COMANDLab/SEA_Exoskeleton/Photos/Design Section.png

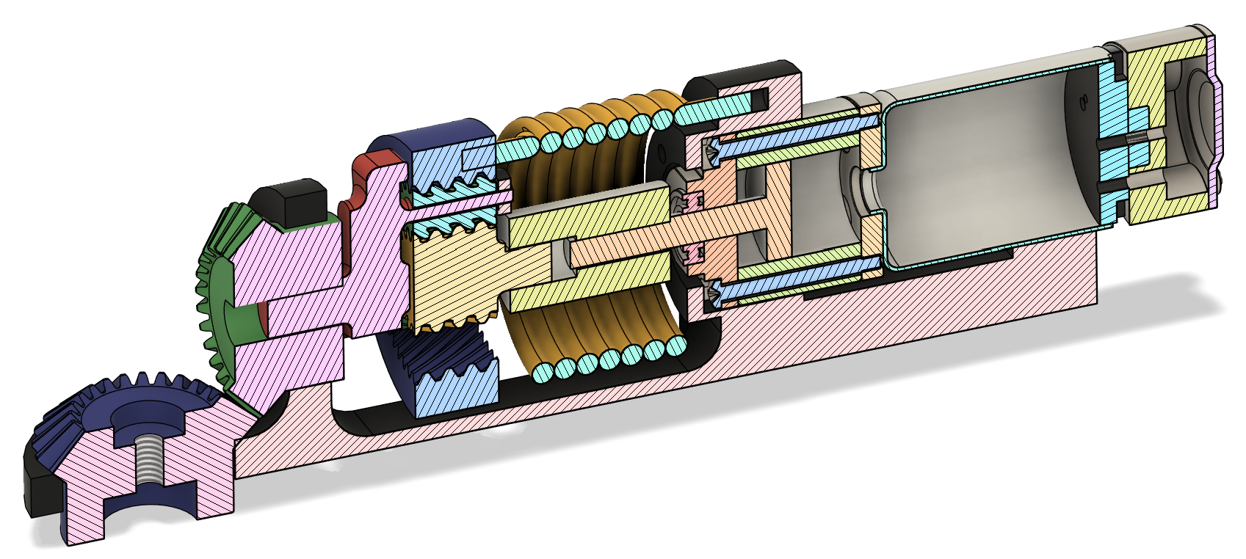
Photos/Design Section.png
