COMANDLab/SEA_Exoskeleton/Photos/Original Design.png

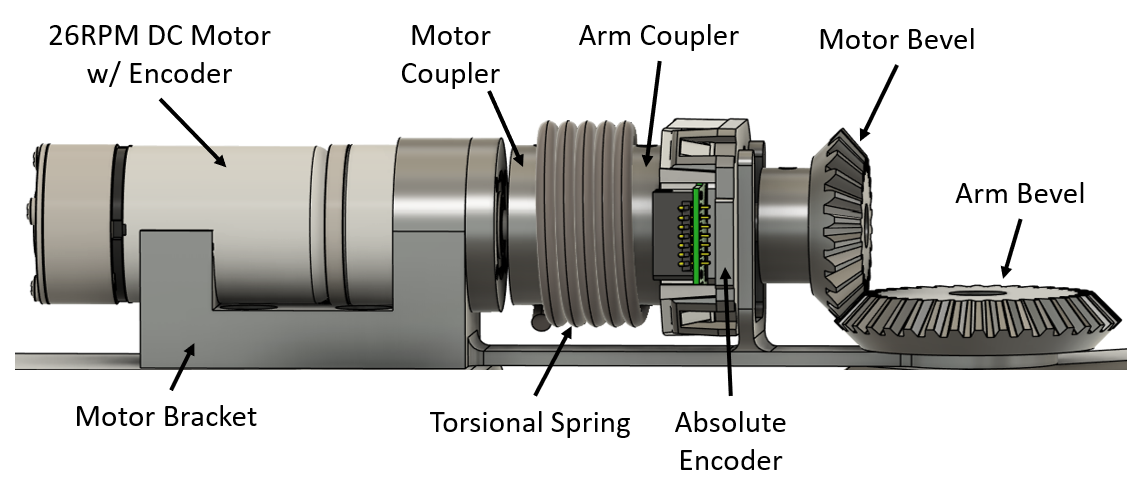
Photos/Original Design.png
