COMANDLab/SEA_Exoskeleton/README.md

# SEA_Exoskeleton
3D Printed Series Elastic Actuator for Elbow Exoskeleton
