COMANDLab/SEA_Exoskeleton/Posters/Hailey Levan Poster.pdf

# Characterizing Joint Compliance and Dynamics in SEA Arm Exoskeleton for Post-Stroke Rehabilitation

Hailey Levan, Ben Jenks, M.S., Dr. Filip Stefanovic, Ph.D.
Department of Biomedical Engineering, State University of New York at Buffalo

## Introduction

Approximately 15 million people experience a stroke

annually, with 62%-88% of survivors suffering from post-

stroke upper limb impairment [1,2]. Rehabilitation

involves intensive repetition of elbow movements, often

limited by patient fatigue or spasticity [3]. Exoskeletons

can assist in such exercises but are often uncomfortable

and may cause injury due to their rigid interactions with

the patient's arm [4]. To address this, a 3D printed

exoskeleton with a Series Elastic Actuator (SEA)

compliant elbow joint was designed. It uses an elastic

elbow joint comprised of a helical planetary gear and a

torsional spring, providing a more comfortable and cost-

effective assistive device for post-stroke rehabilitation [4].

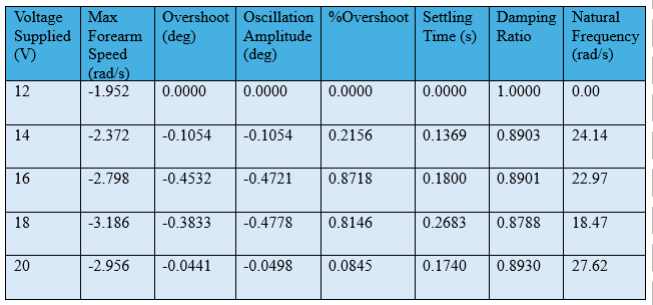
[picture p3: figure]

## Experimental Methods

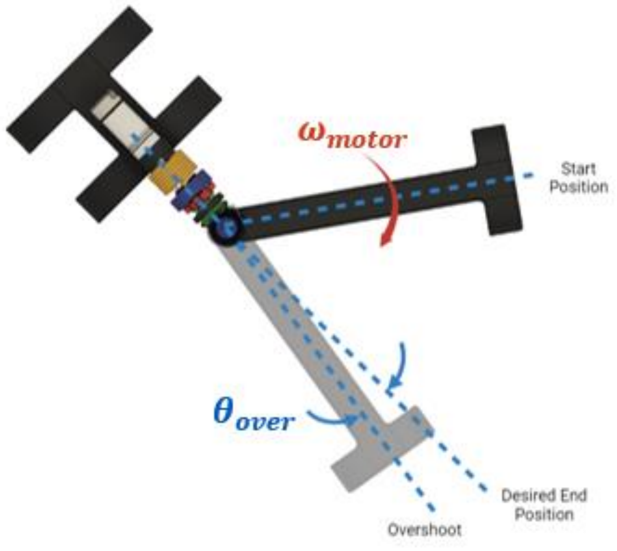
[picture p4: figure]
Figure A: neque dignissim, and in aliquet nisl et umis.

## Results

## Conclusion

## References

1. WHO EMRO | Stroke, Cerebrovascular accident | Health topics.
(n.d.). World Health Organization - Regional Office for the Eastern Mediterranean. https://www.emro.who.int/health-topics/strokecerebrovascular-accident/index.html
2. Stinear, C. M., Lang, C. E., Zeiler, S., & Byblow, W. D. (2020). Advances and challenges in stroke rehabilitation. Lancet Neurology, 19(4), 348–360. https://doi.org/10.1016/s1474-4422(19)30415-6
3. Kawahira, K., Shimodozono, M., Etoh, S., Kamada, K., Noma, T., & Tanaka, N. (2010). Effects of intensive repetition of a new facilitation technique on motor functional recovery of the hemiplegic upper limb and hand. Brain Injury, 24(10), 1202–1213. https://doi.org/10.3109/02699052.2010.506855
4. Jenks, B., & Stefanovic, F. (2024). Planetary Gear Series Elastic Actuation for a Compliant Exoskeleton Joint. COMAND Lab, Department of Biomedical Engineering.

www.buffalo.edu

This study characterizes the compliance and dynamics of a planetary gear/torsional spring SEA exoskeleton design to improve elbow joint rehabilitation. Under static loads, the joint achieved a total system compliance of 22.22°

,
with the torsional spring contributing 7.42° of compliance for user safety and comfortability.

In a dynamic test in which the joint’s motor was supplied with different voltage levels, the system was found to maintain a relatively constant damping ratio, even at higher speeds. In general, a higher forearm rotation speed resulted in larger overshoot angles, as well as longer settling times before the system reached steady state.

Future work may include incorporating machine learning to recognize user intent and EMG sensors. These steps would further develop the device to improve rehabilitation success, with the hope of it eventually being utilized as an every day assistive device.

## Acknowledgments

## climb up for summer research

Special thanks to the following organizations for their parts in funding this research:
❖ The Research Foundation for the State University of New York ❖ National Science Foundation Disabilities and Rehabilitation Engineering (Award#: 2130651)
❖ CLIMB Undergraduate Program

Fig 1 (Jenks, B. & Stefanovic, F.):
Top
Component view of torsional spring and planetary gear SEA joint. Bottom
Full model of the SEA device interaction with exoskeleton brackets.

Test 1: Static compliance test

❖ Method: Apply force until spring starts to deform,

then record joint angle using IMUs.

Fig 2 (Created with BioRender): Schematic for static testing procedure.

Fig 3 (Created with BioRender): Schematic for dynamic testing procedure.

To determine the compliancy of the SEA elbow joint,

two tests were run to characterize the device.

Test 2: Dynamic compliance test

❖ Method: Vary speed at which forearm rotates to

desired angle. Collect joint angle data to observe

overshoot and oscillations caused by SEA joint.

❖ Hypothesis: Increased forearm rotation speed = larger

overshoot and subsequent oscillations before

stabilizing.

Test 1: Static compliance test

❖ Across 4 trials each, the average system compliance

(Csys) and the average gear compliance (Cgear ) were

measured.

Csys = 22.22°

Cgear = 14.80°

❖ Spring compliance (Cspring) can be calculated

through:

Cspring = Csys − Cgear = 7.42°

Test 2: Dynamic compliance test

❖ Raw angular velocity data for the forearm was

integrated in MATLAB to acquire angular position data.

Fig 4 (H. Levan):
Example of MATLAB graph created for 5 trials ranging from 12-18V. Zoomed in to better view the moment of overshoot and subsequent transition to steady state.

❖ Within MATLAB, percent overshoot (%os) and settling

time (Ts
) were calculated. With these parameters, the

following equations were used to calculate the damping

ratio (ζ) and natural frequency (ωn) of the system. Table

1 contains all important parameters to characterize the

dynamics of the joint when its motor is supplied with

different voltage levels.

ζ =

ln(

100
%os

)

π

2 + (ln

100
%os

)

2

ωn =

4
Tsζ

Table 1: Necessary parameters to characterize joint dynamics. .
