COMANDLab/SEA_Exoskeleton/Photos/3 Nm arm gears displacement.png

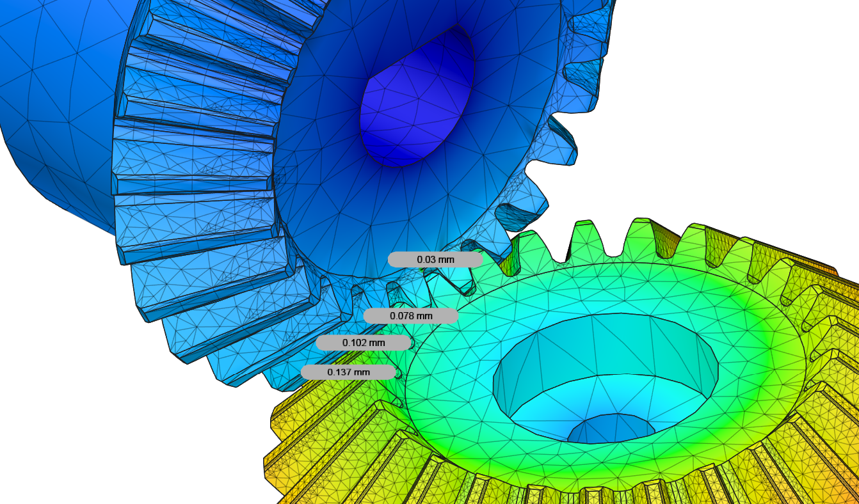
Photos/3 Nm arm gears displacement.png
