COMANDLab/SEA_Exoskeleton/Photos/3 Nm arm gears stress x-axis.png

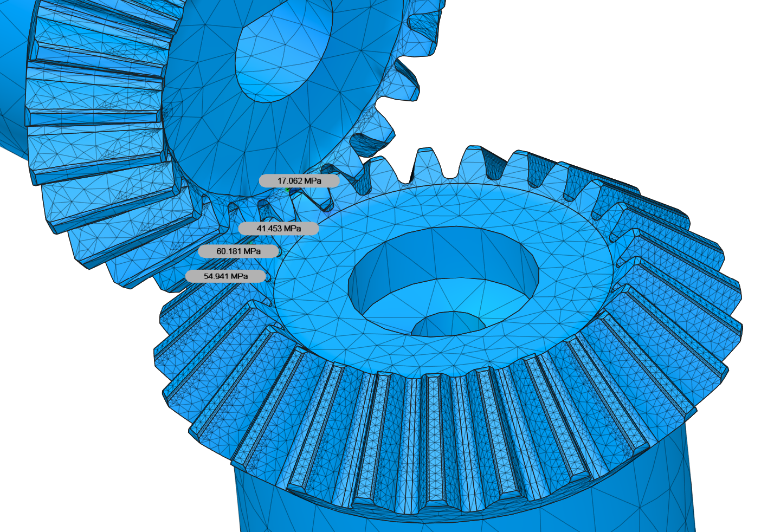
Photos/3 Nm arm gears stress x-axis.png
