COMANDLab/SEA_Exoskeleton/Photos/3 Nm arm gears stress y-axis.png

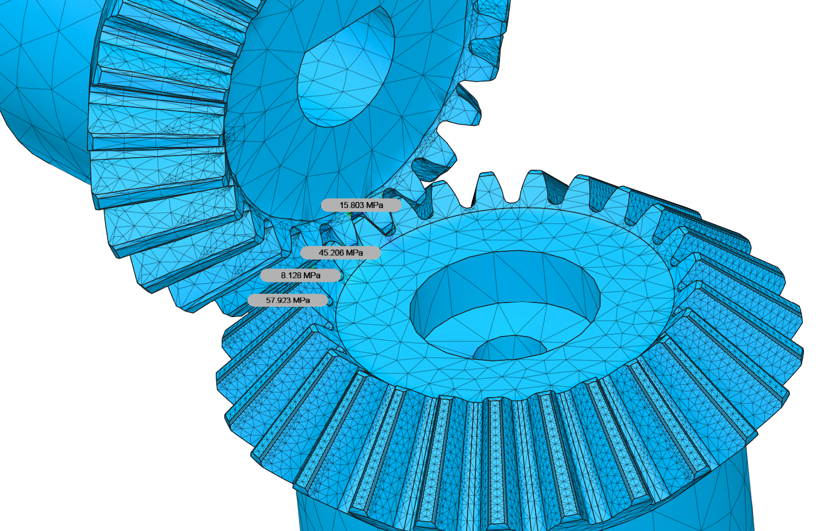
Photos/3 Nm arm gears stress y-axis.png
