COMANDLab/SEA_Exoskeleton/Photos/3 Nm arm gears stress z-axis.png

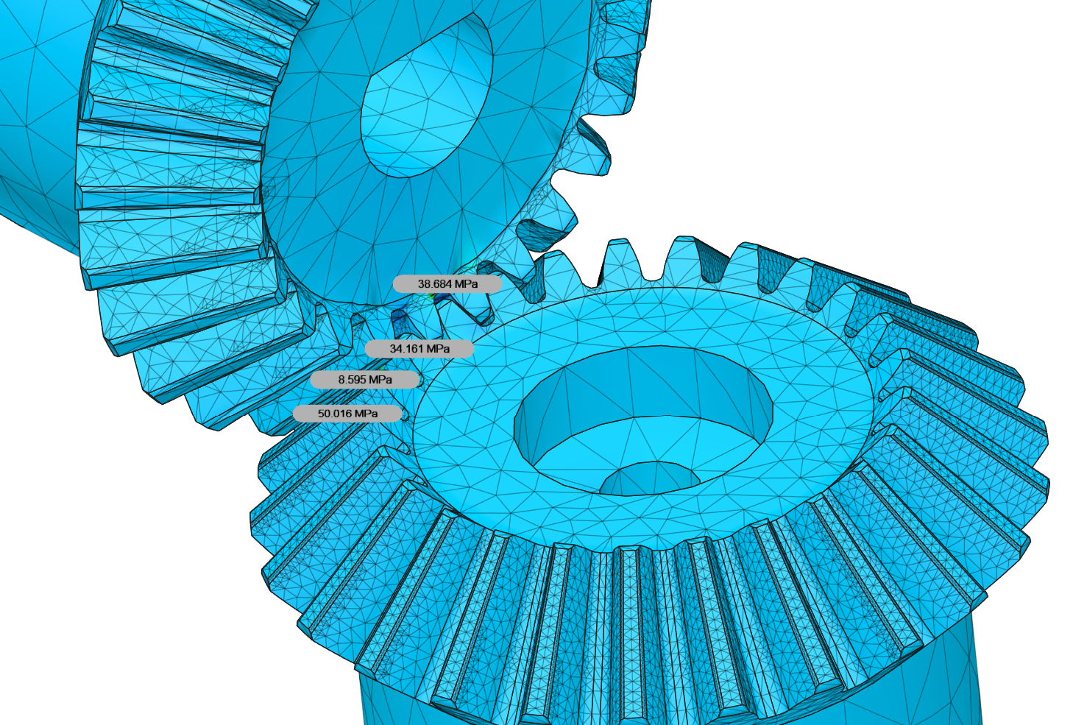
Photos/3 Nm arm gears stress z-axis.png
