COMANDLab/SEA_Exoskeleton/Photos/3 Nm displacement arm side.png

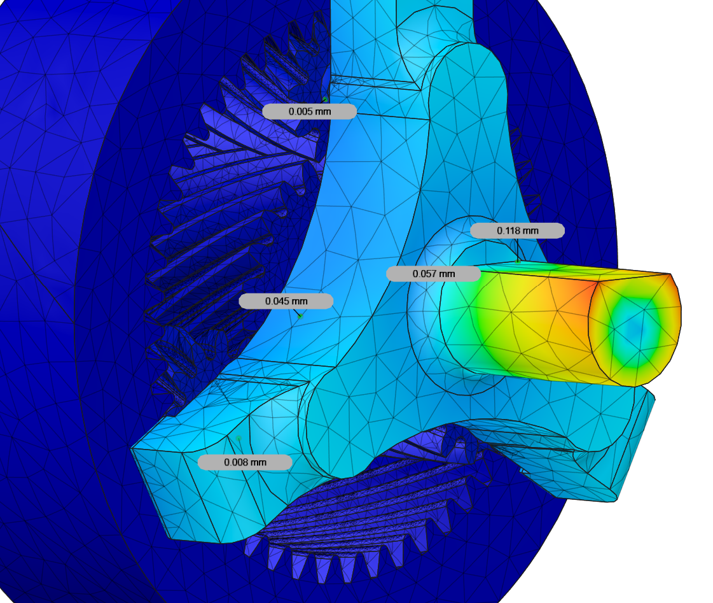
Photos/3 Nm displacement arm side.png
