COMANDLab/SEA_Exoskeleton/Photos/3 Nm displacement sun side.png

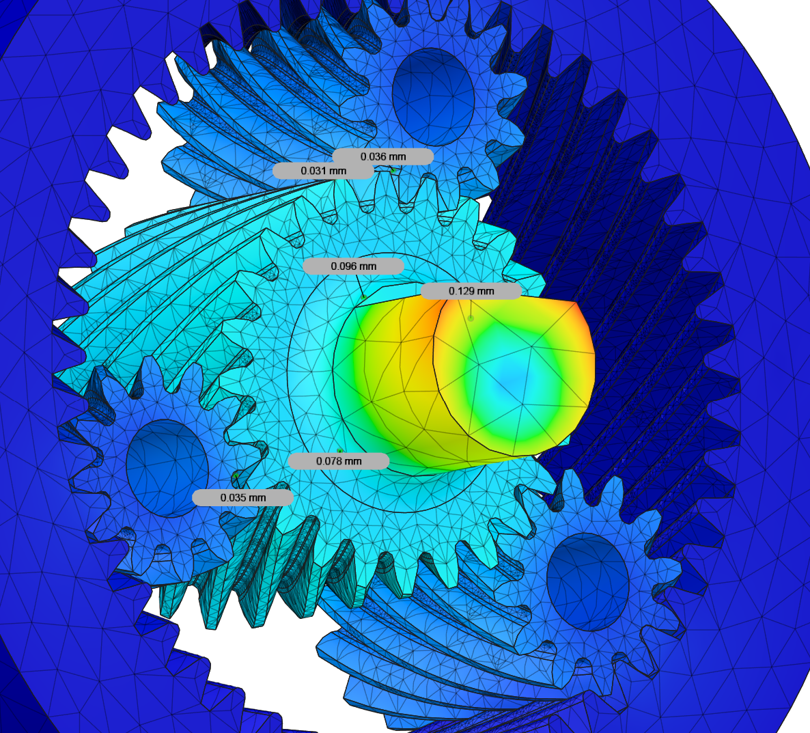
Photos/3 Nm displacement sun side.png
