COMANDLab/SEA_Exoskeleton/Photos/3 Nm stress arm side x-axis.png

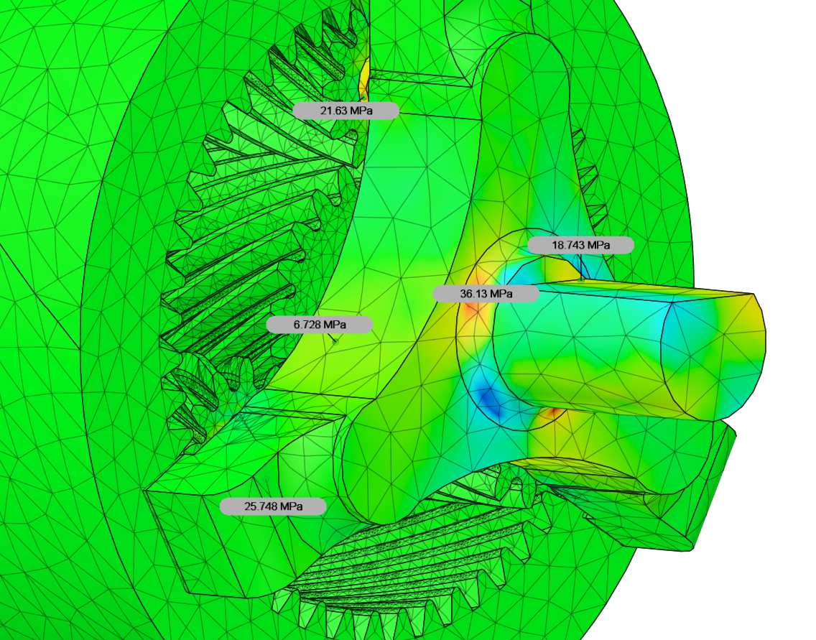
Photos/3 Nm stress arm side x-axis.png
