COMANDLab/SEA_Exoskeleton/Photos/3 Nm stress arm side y-axis.png

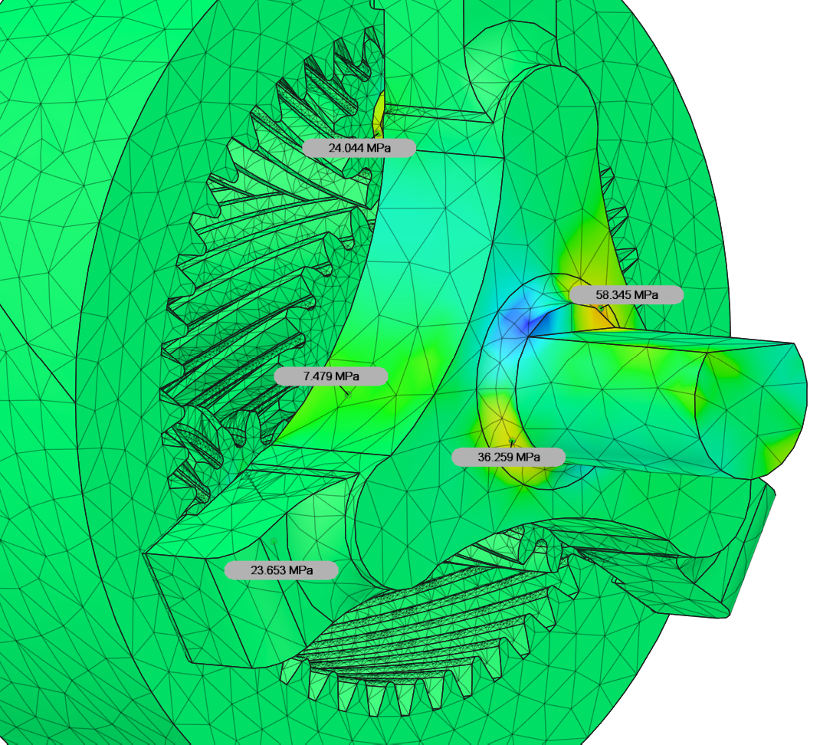
Photos/3 Nm stress arm side y-axis.png
