COMANDLab/SEA_Exoskeleton/Photos/3 Nm stress sun side x-axis.png

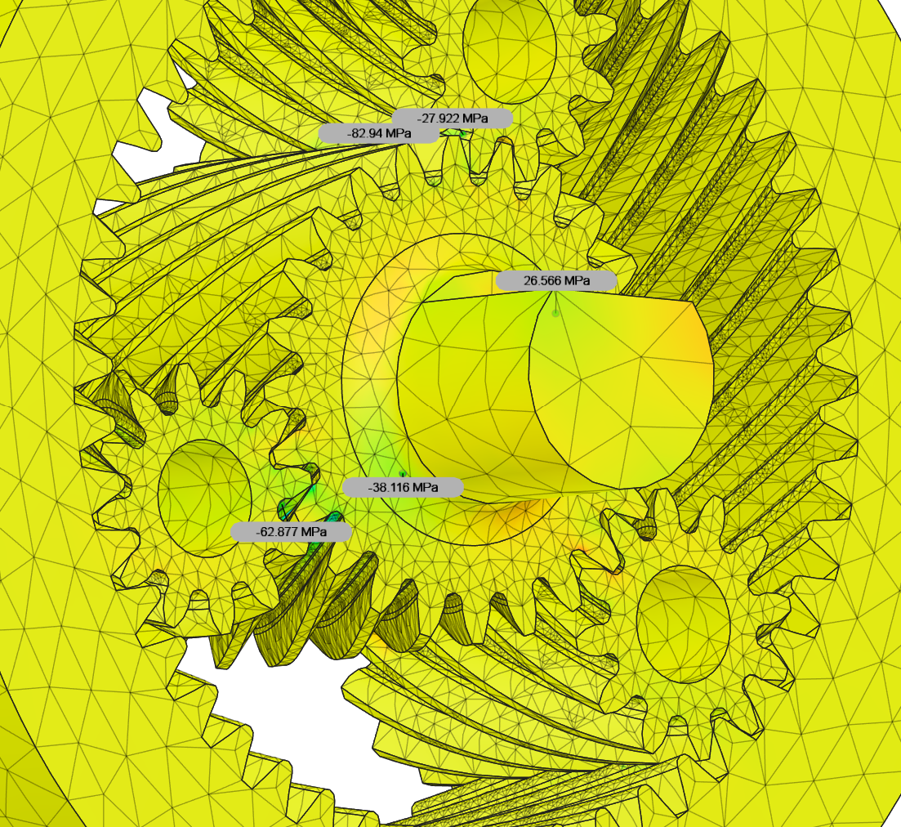
Photos/3 Nm stress sun side x-axis.png
