COMANDLab/SEA_Exoskeleton/Photos/3 Nm stress sun side y-axis.png

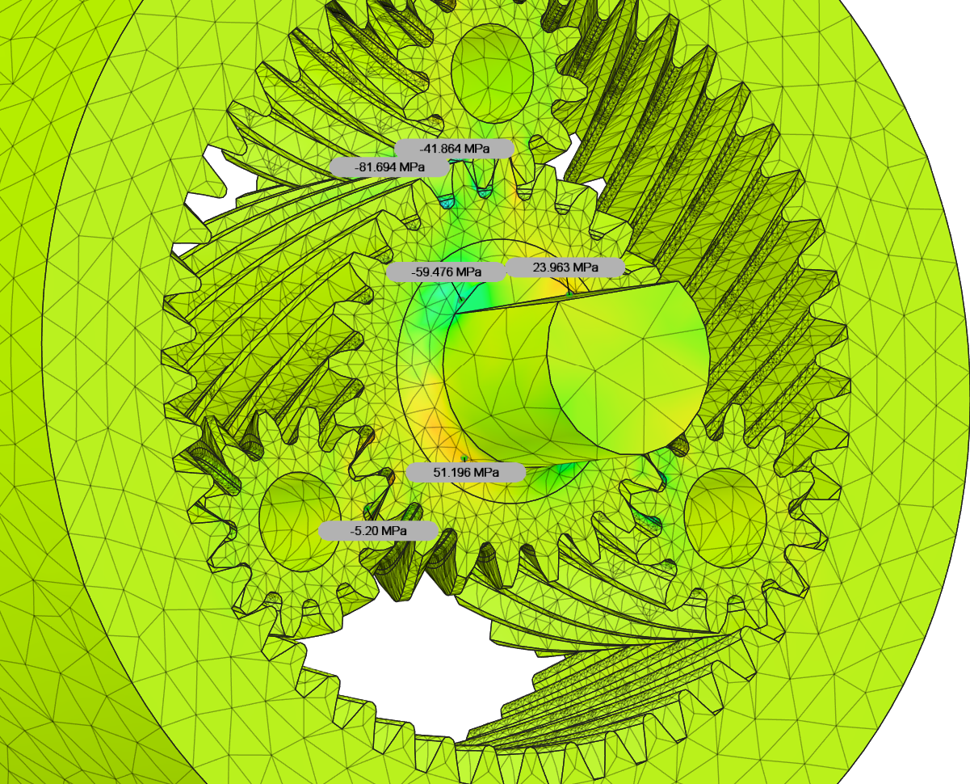
Photos/3 Nm stress sun side y-axis.png
