COMANDLab/SEA_Exoskeleton/Photos/brace.png

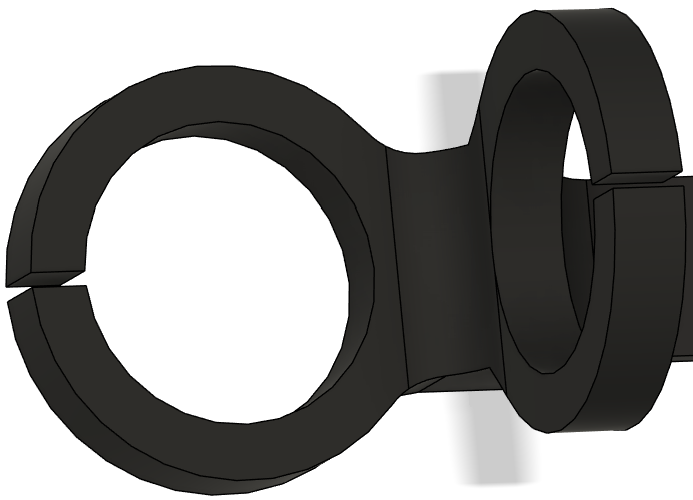
Photos/brace.png
