COMANDLab/SEA_Exoskeleton/Photos/Compliant Actuator.png

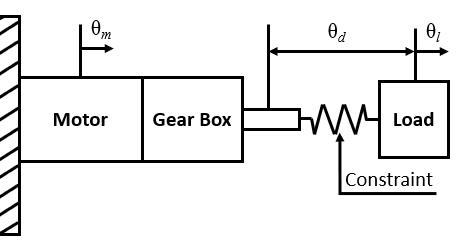
Photos/Compliant Actuator.png
