COMANDLab/SEA_Exoskeleton/Photos/compliant arm.png

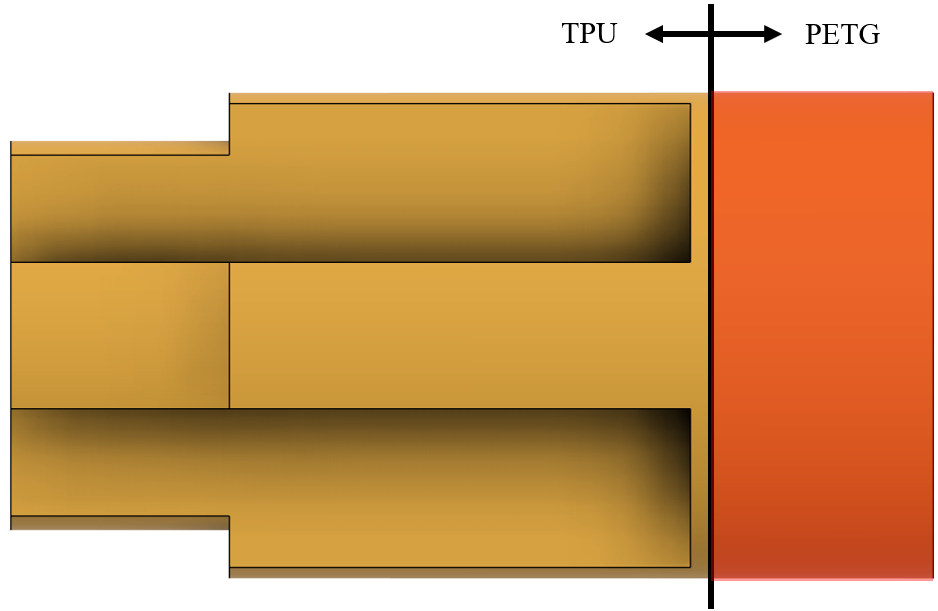
Photos/compliant arm.png
