COMANDLab/SEA_Exoskeleton/Photos/compliant section.png

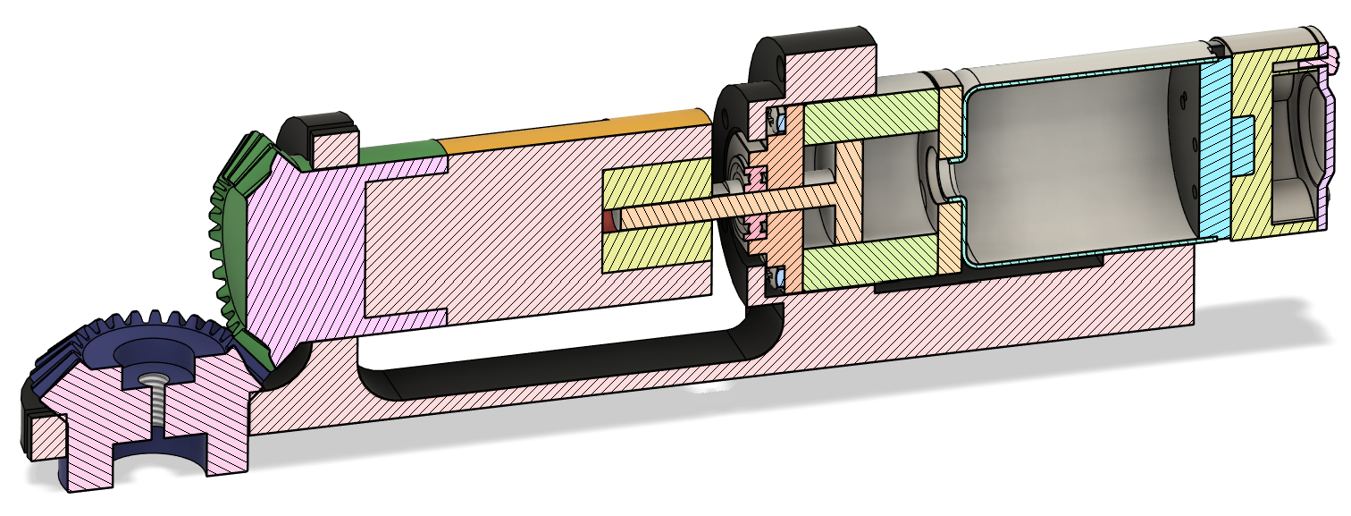
Photos/compliant section.png
