COMANDLab/SEA_Exoskeleton/Photos/Compliant Side View.png

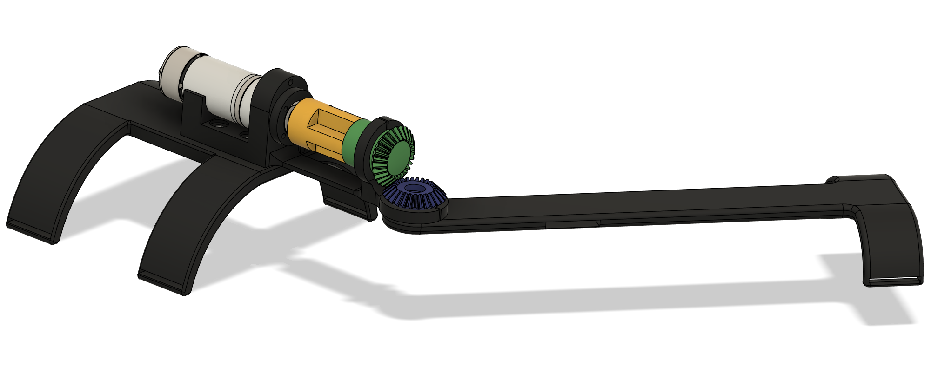
Photos/Compliant Side View.png
