COMANDLab/SEA_Exoskeleton/Photos/cPEA cross.png

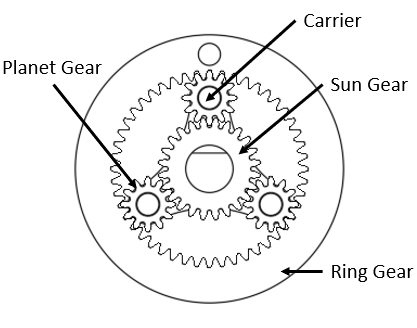
Photos/cPEA cross.png
