COMANDLab/SEA_Exoskeleton/Photos/Dynamic Model.png

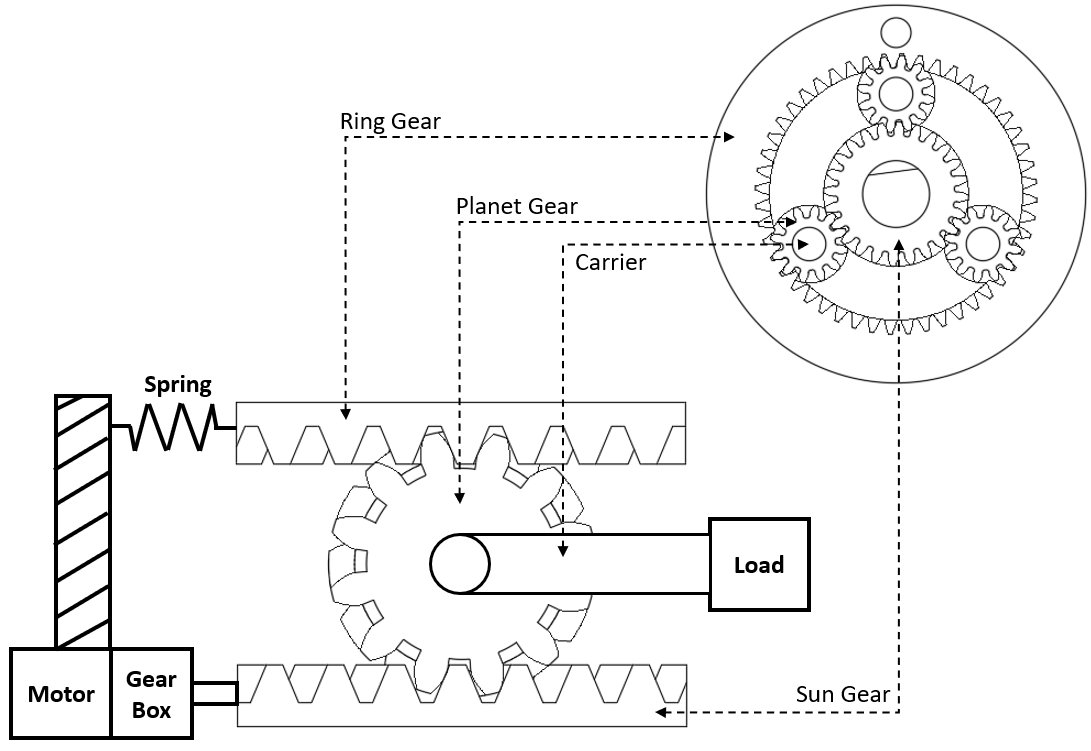
Photos/Dynamic Model.png
