COMANDLab/SEA_Exoskeleton/Photos/Final Design Labeled Componenets.png

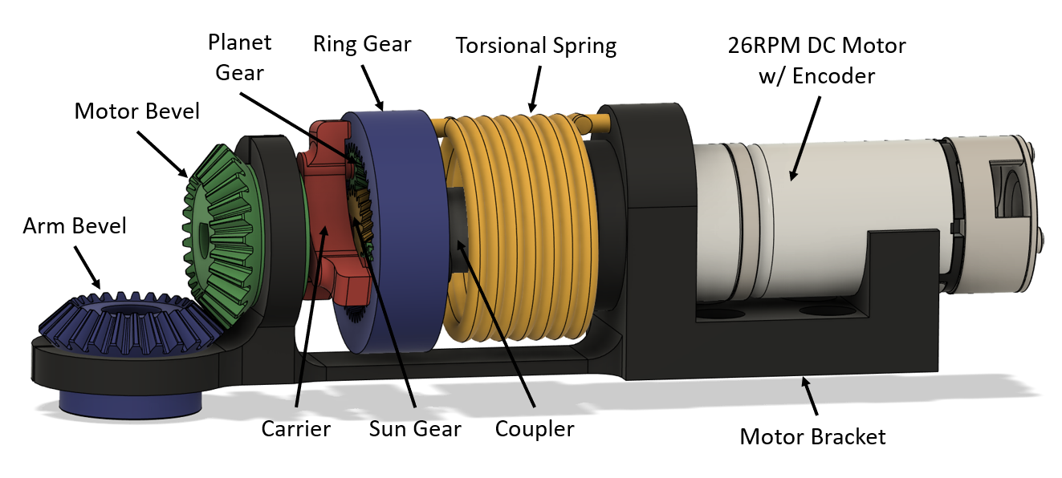
Photos/Final Design Labeled Componenets.png
