COMANDLab/SEA_Exoskeleton/Photos/Final Model Compliant Arm Labeled.png

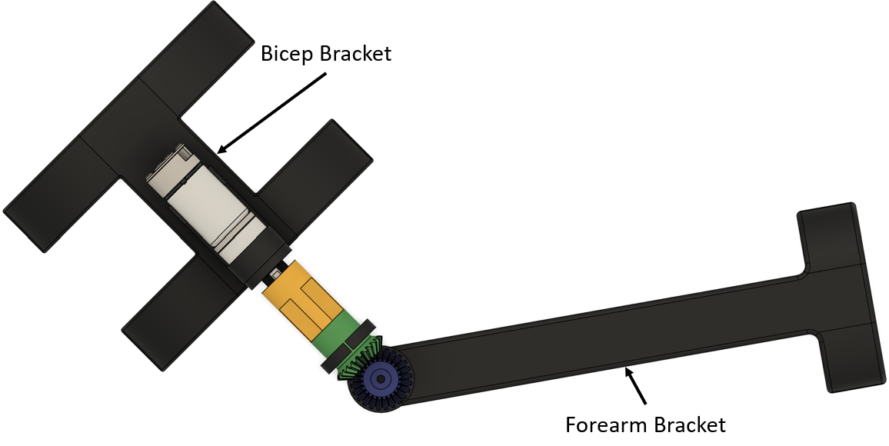
Photos/Final Model Compliant Arm Labeled.png
