COMANDLab/SEA_Exoskeleton/Photos/Final Model Compliant Arm.png

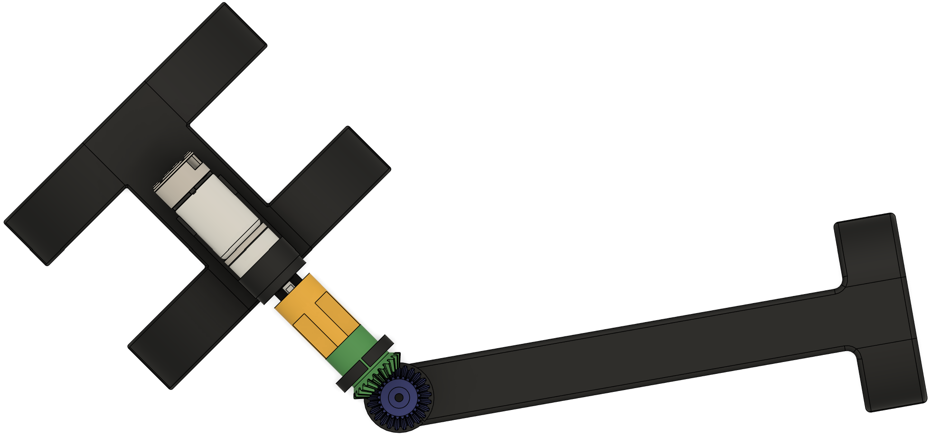
Photos/Final Model Compliant Arm.png
