COMANDLab/SEA_Exoskeleton/Photos/Final Model Compliant Labeled Componenets.png

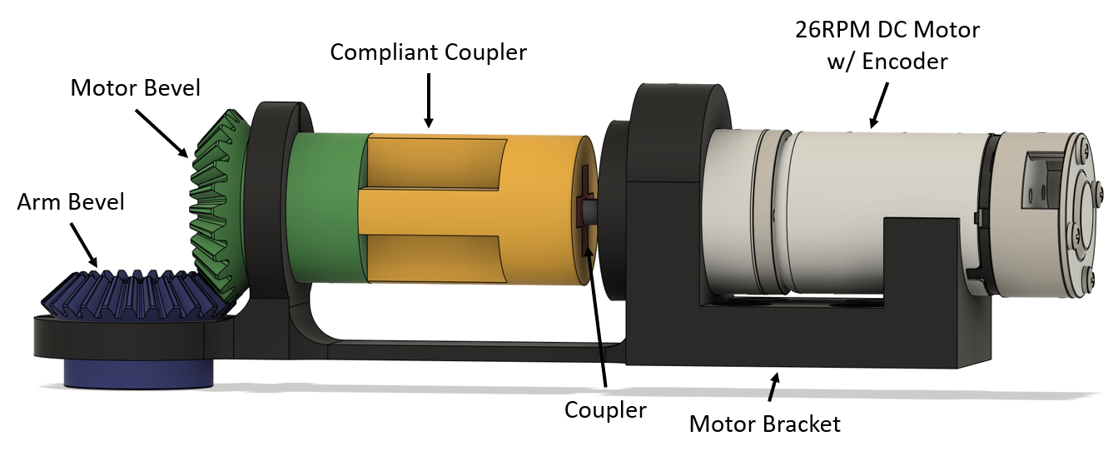
Photos/Final Model Compliant Labeled Componenets.png
