COMANDLab/SEA_Exoskeleton/Photos/Final Model Compliant Section Labeled.png

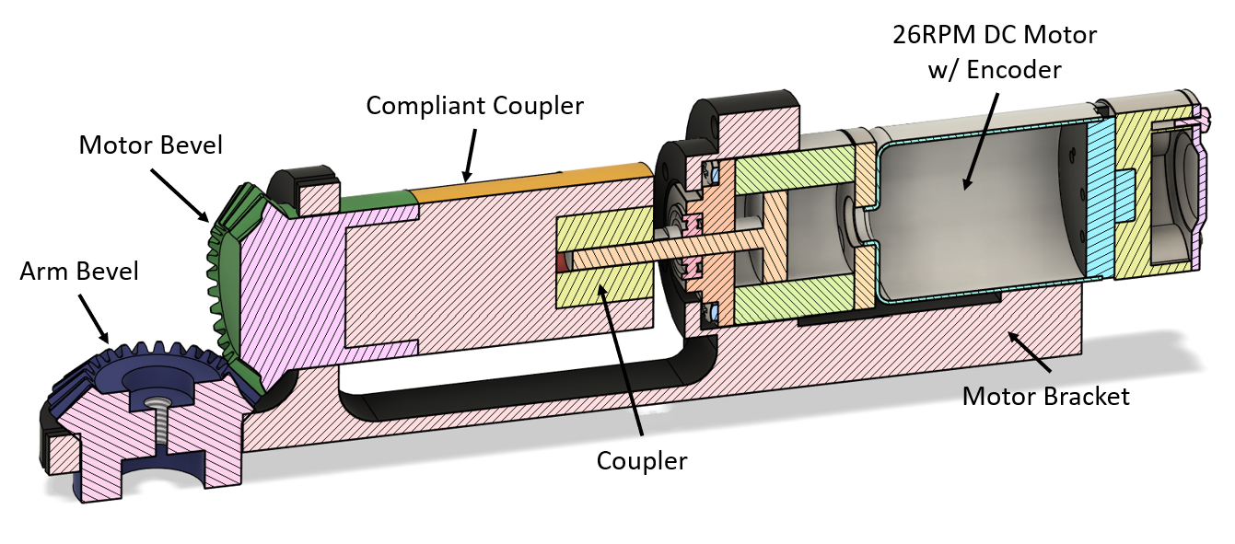
Photos/Final Model Compliant Section Labeled.png
