COMANDLab/SEA_Exoskeleton/Photos/Final Model Spring Labeled.png

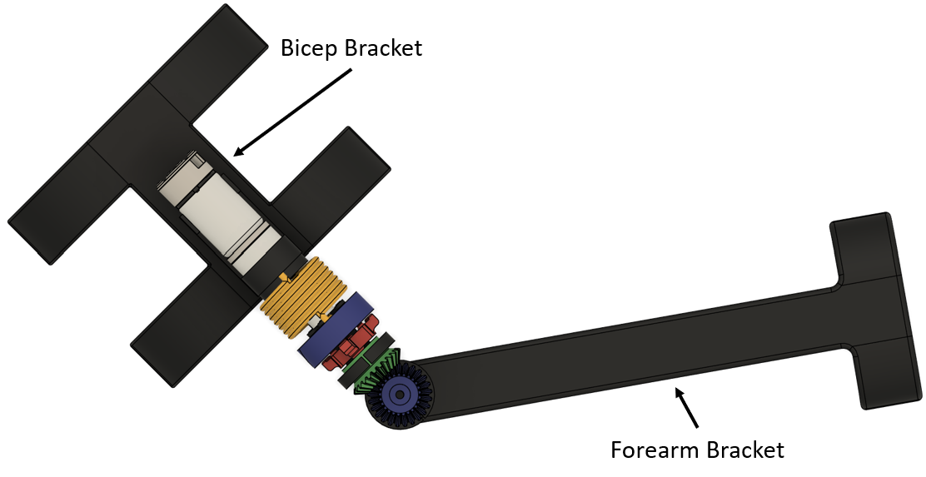
Photos/Final Model Spring Labeled.png
