COMANDLab/SEA_Exoskeleton/Photos/Forearm Cuff.png

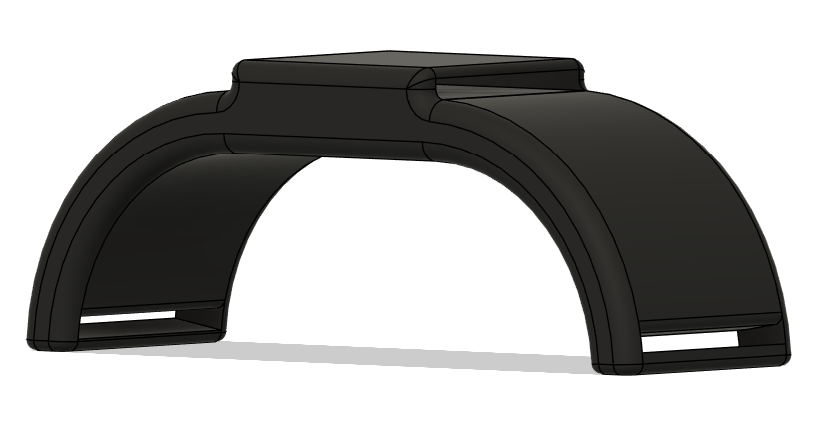
Photos/Forearm Cuff.png
