COMANDLab/SEA_Exoskeleton/Photos/Motor bracket.png

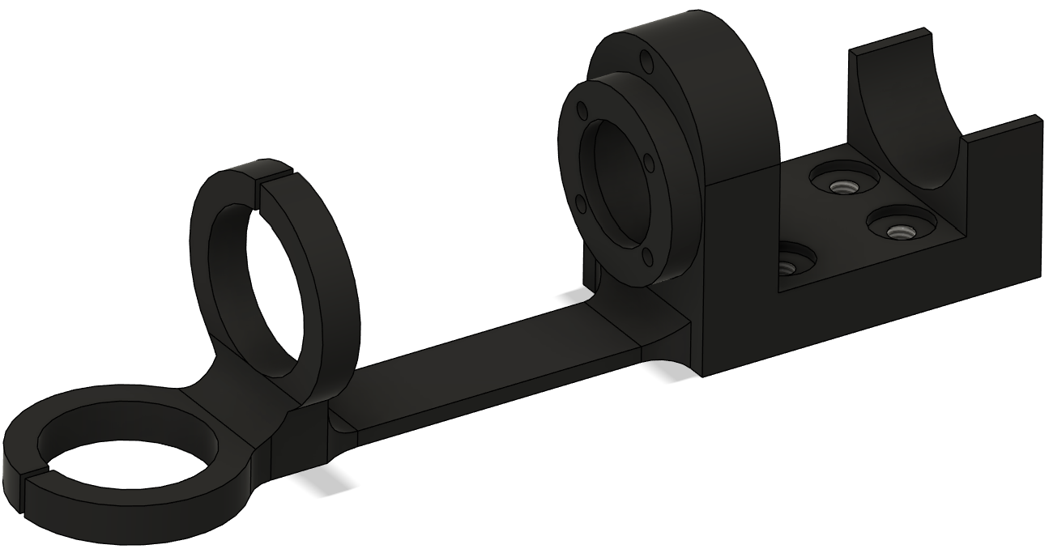
Photos/Motor bracket.png
