COMANDLab/SEA_Exoskeleton/Photos/Motor w Encoder.jpg

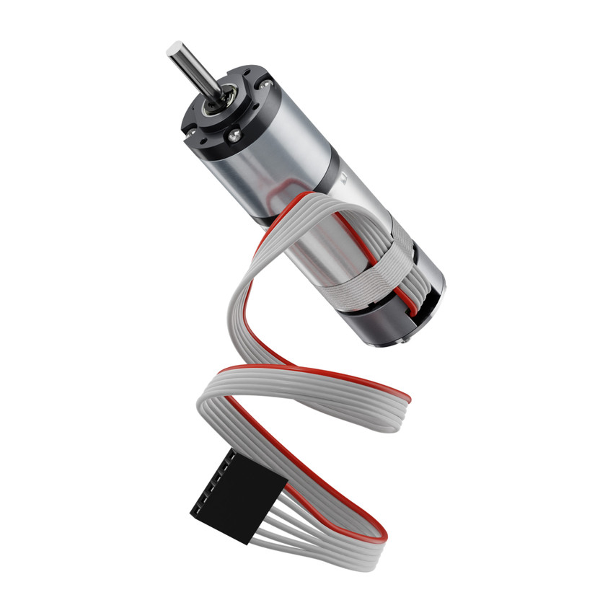
Photos/Motor w Encoder.jpg
