COMANDLab/SEA_Exoskeleton/Photos/origianl cuff.png

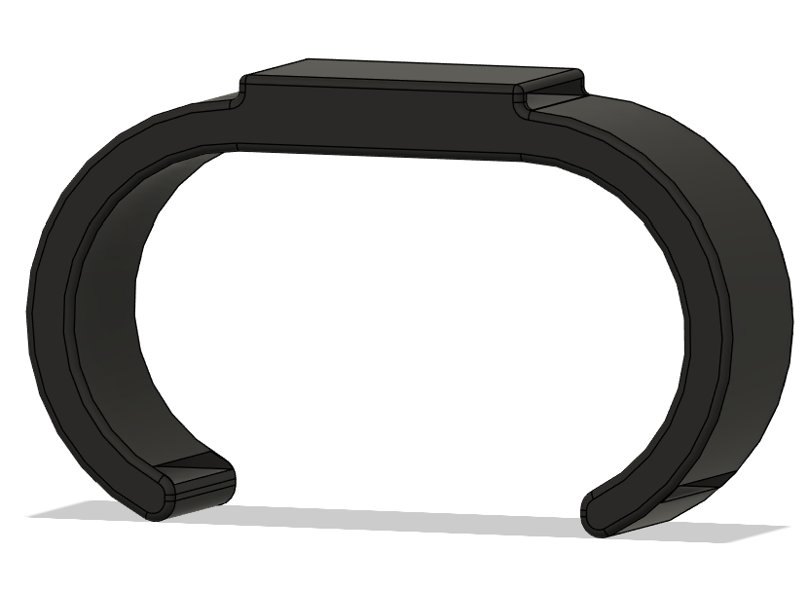
Photos/origianl cuff.png
