COMANDLab/SEA_Exoskeleton/Photos/planetary gear.png

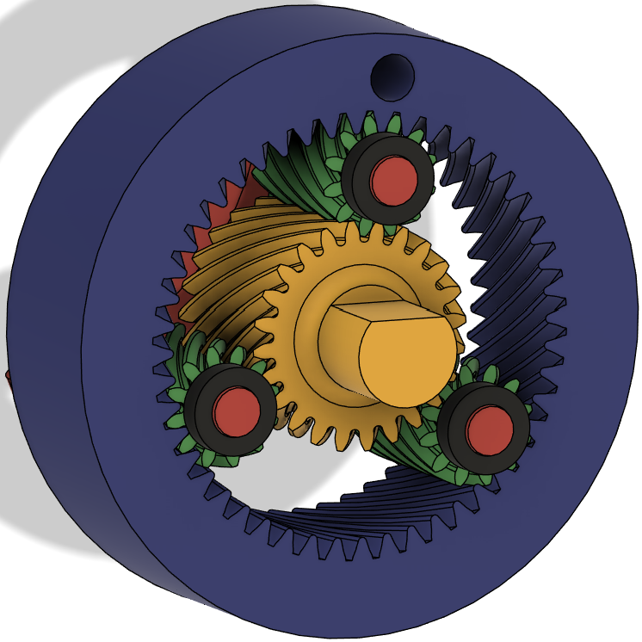
Photos/planetary gear.png
