COMANDLab/SEA_Exoskeleton/Photos/position change.png

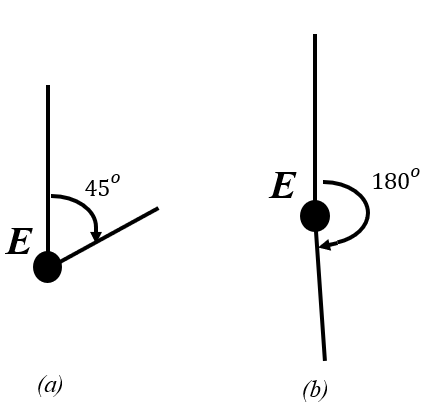
Photos/position change.png
