COMANDLab/SEA_Exoskeleton/Photos/Schematics/Arm Bevel Drawing.png

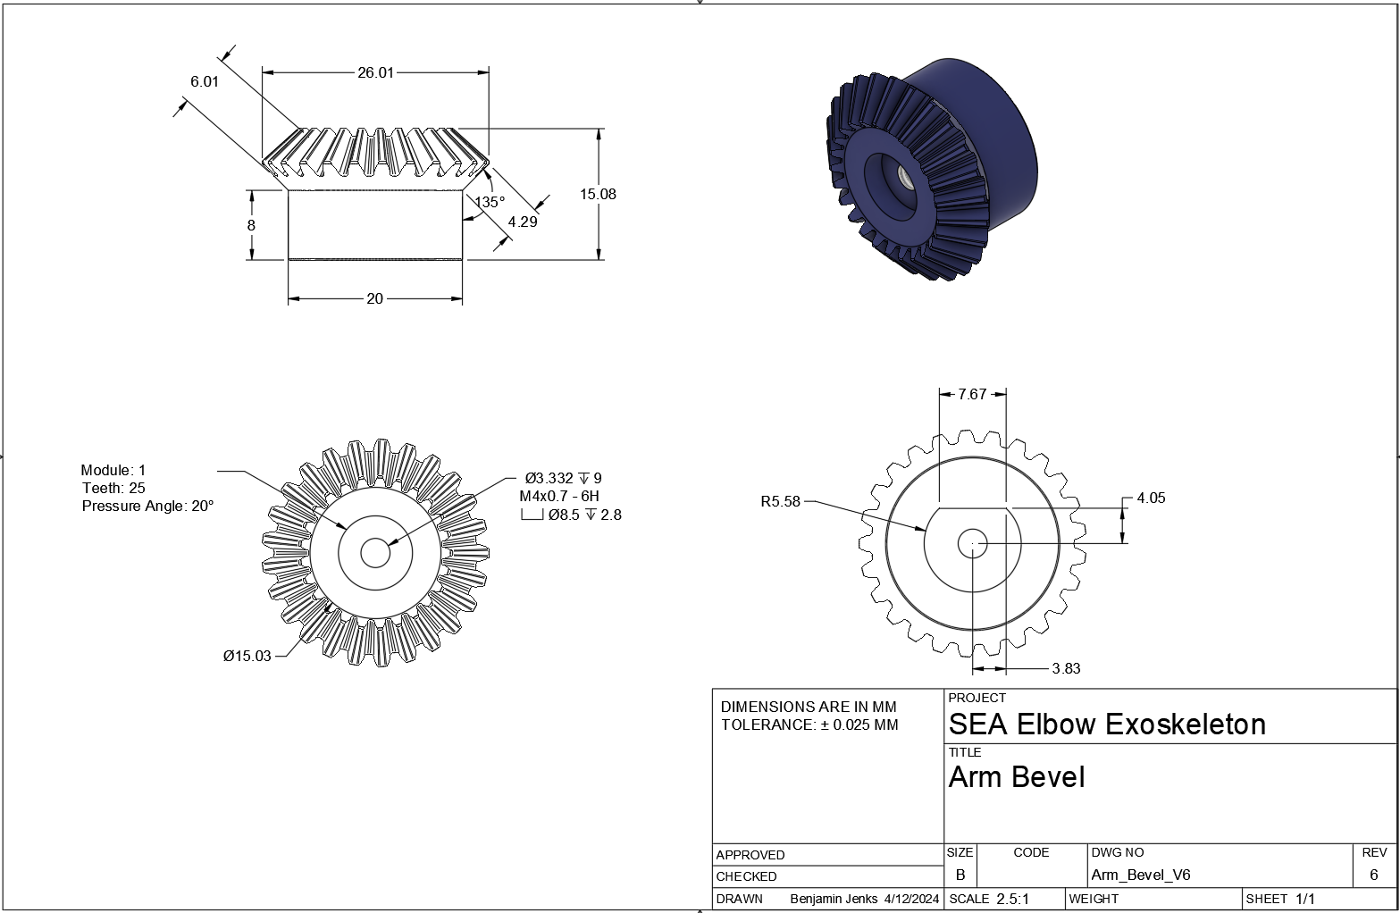
Photos/Schematics/Arm Bevel Drawing.png
