COMANDLab/SEA_Exoskeleton/Photos/Schematics/Bicep Drawing.png

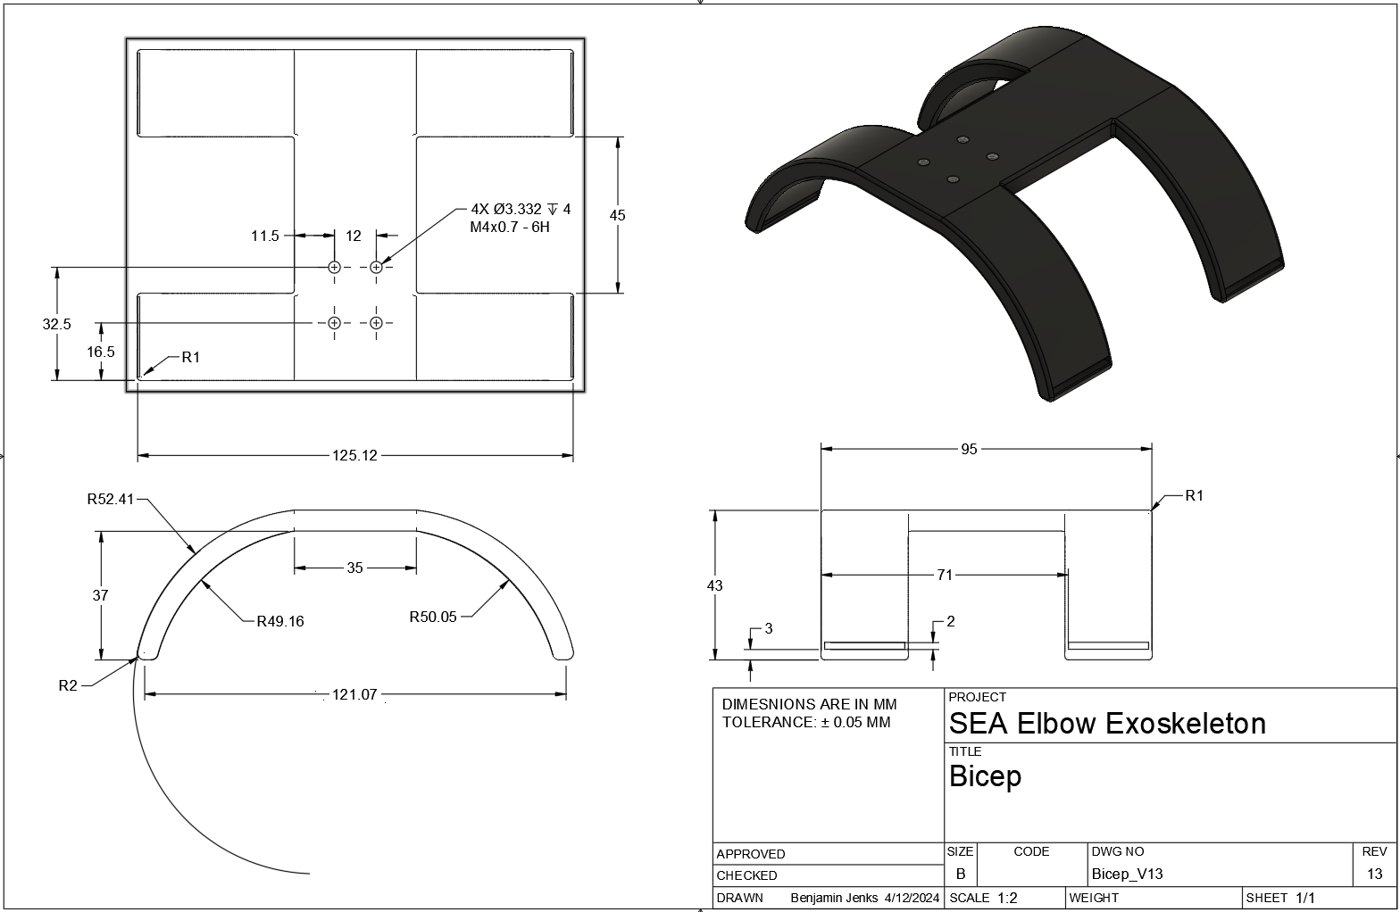
Photos/Schematics/Bicep Drawing.png
