COMANDLab/SEA_Exoskeleton/Photos/Schematics/Carrier Arm Drawing.png

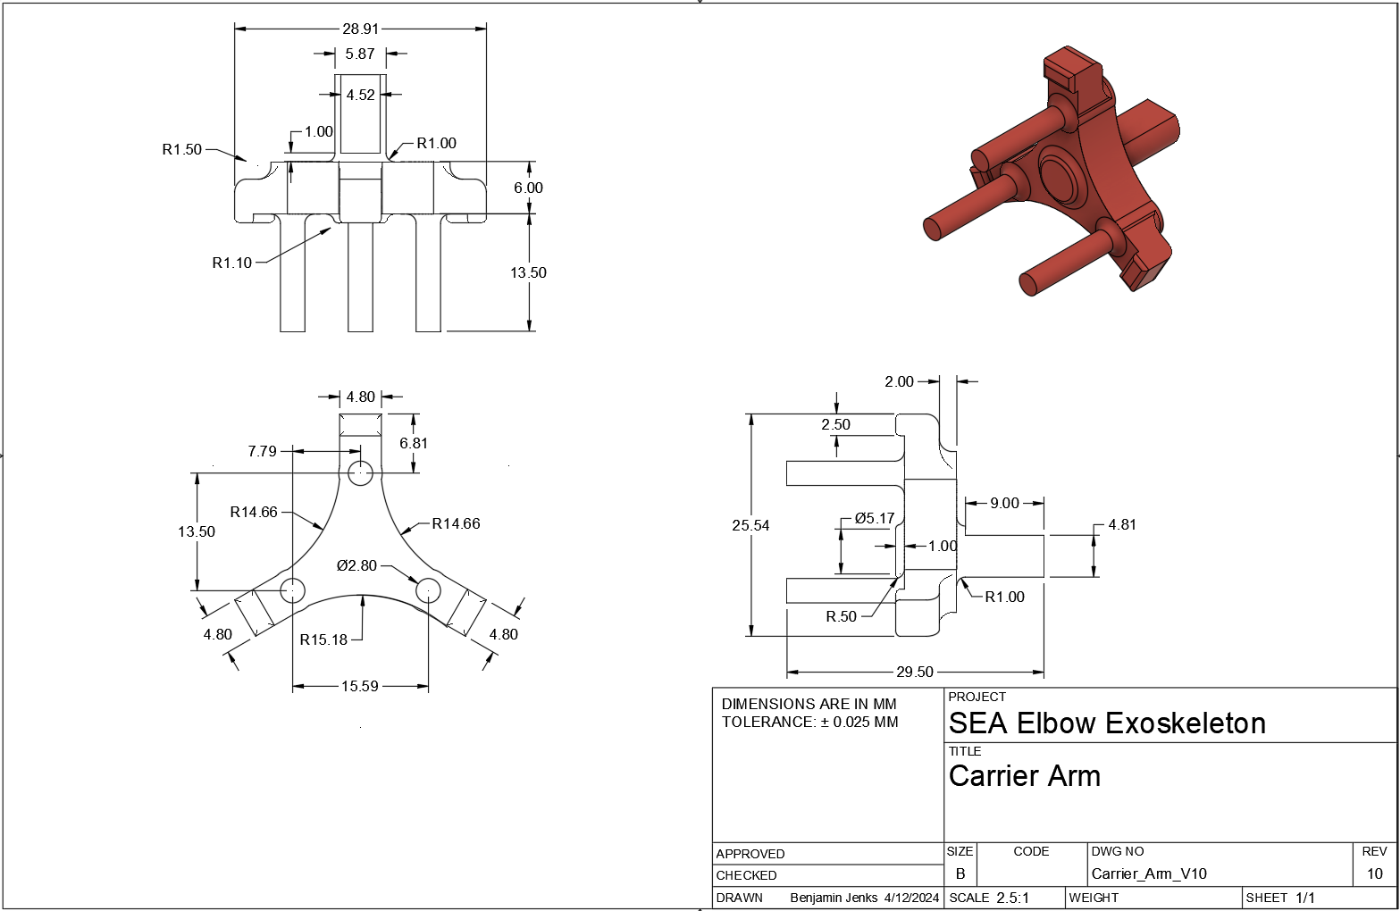
Photos/Schematics/Carrier Arm Drawing.png
