COMANDLab/SEA_Exoskeleton/Photos/Schematics/Compliant Arm Drawing.png

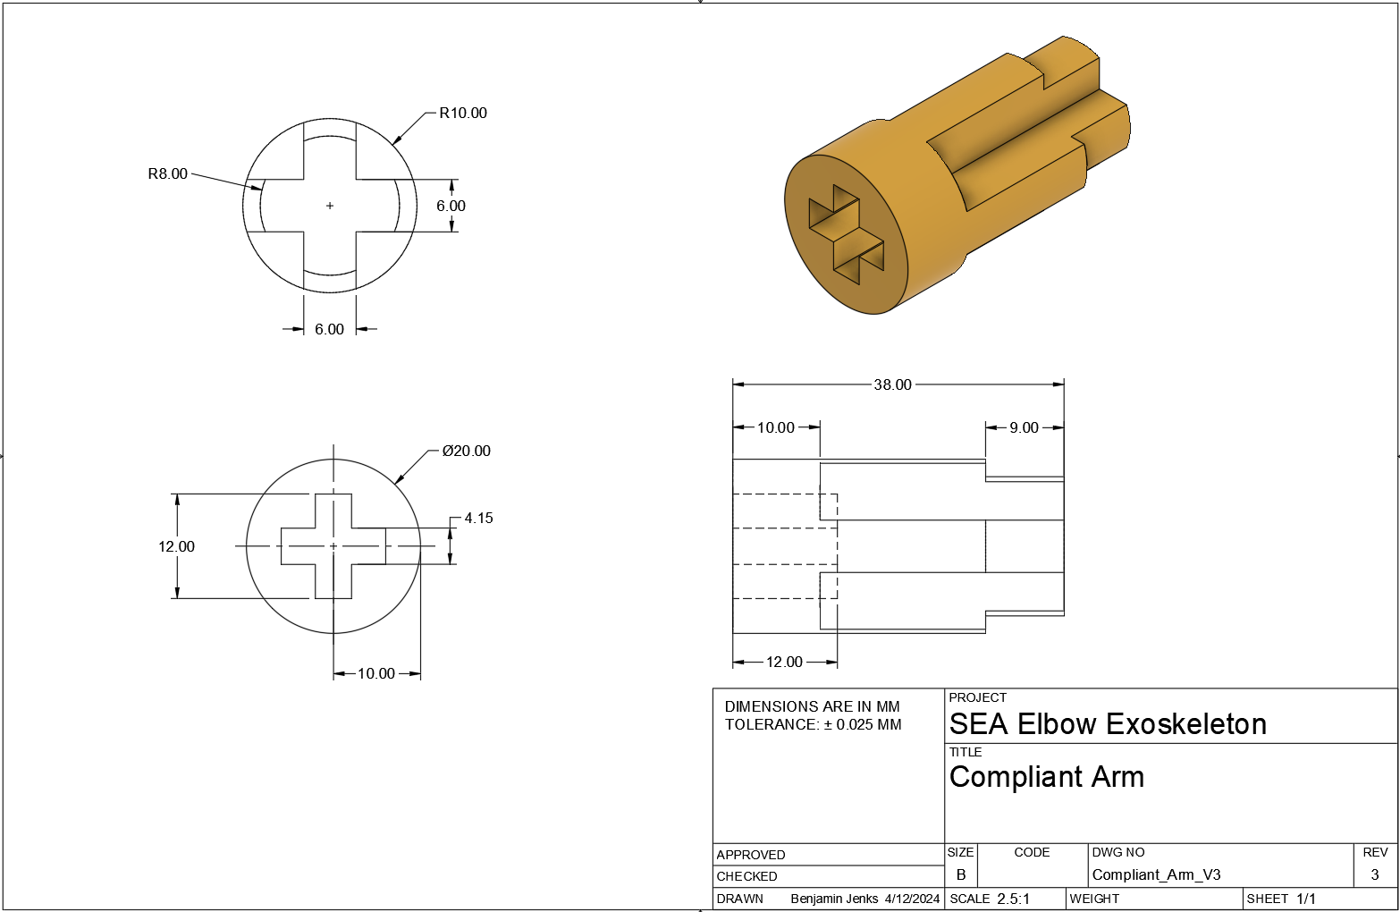
Photos/Schematics/Compliant Arm Drawing.png
