COMANDLab/SEA_Exoskeleton/Photos/Schematics/Coupler Drawing.png

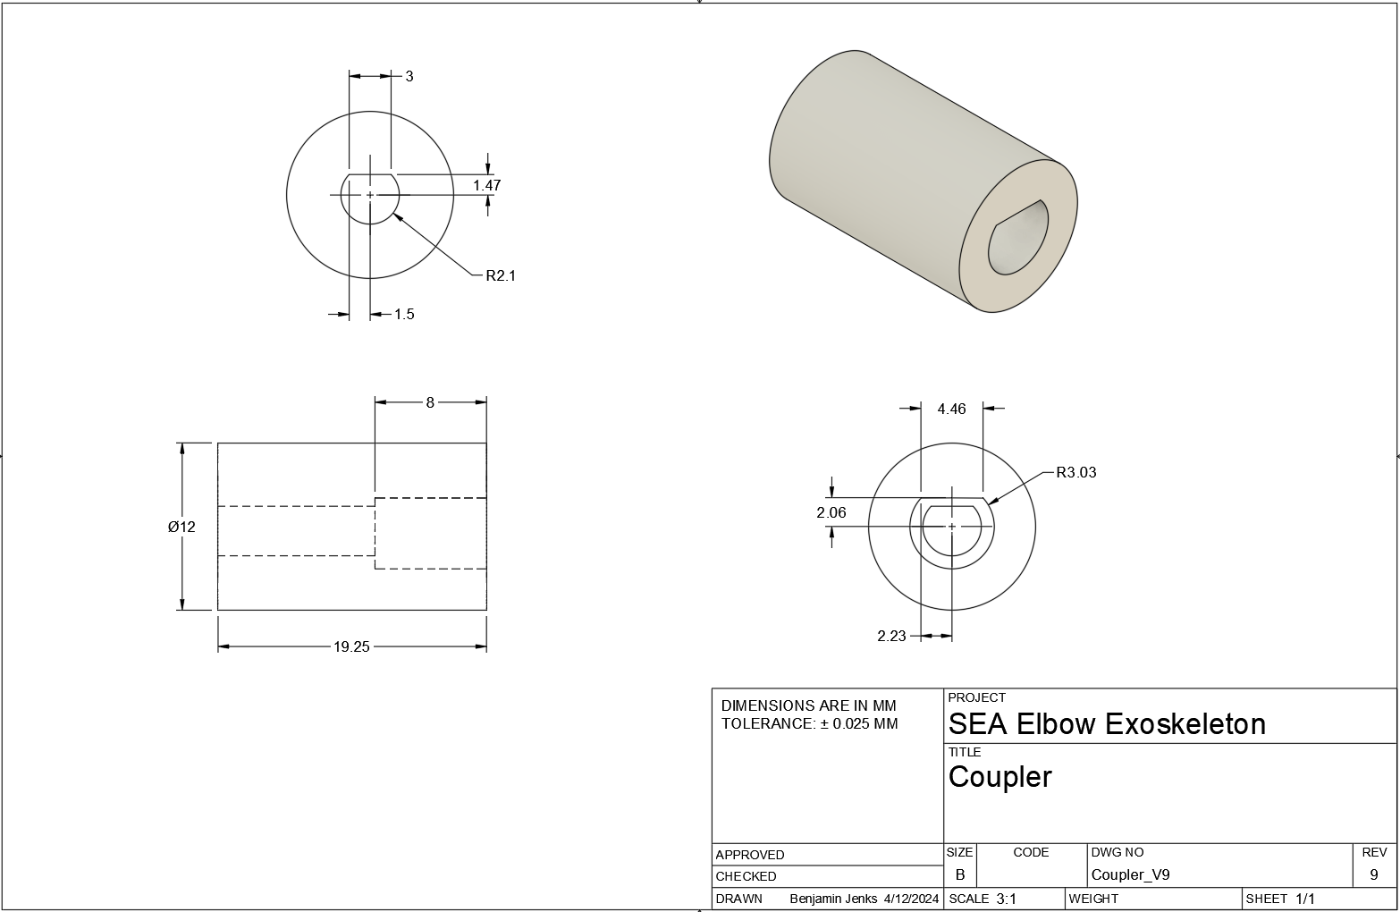
Photos/Schematics/Coupler Drawing.png
