COMANDLab/SEA_Exoskeleton/Photos/Schematics/Forearm Drawing.png

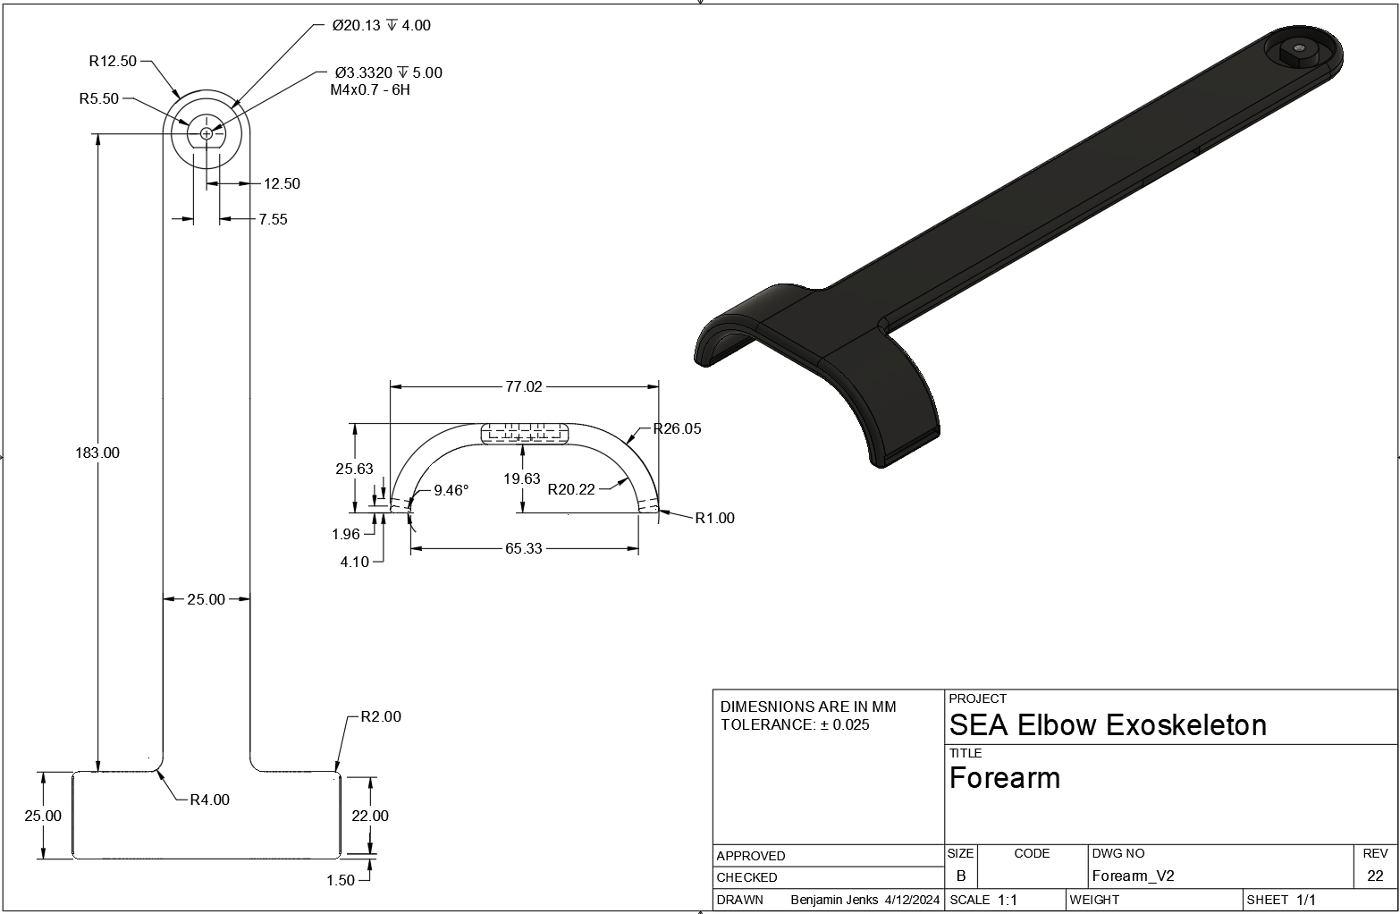
Photos/Schematics/Forearm Drawing.png
