COMANDLab/SEA_Exoskeleton/Photos/Schematics/Motor Bevel Compliant Drawing.png

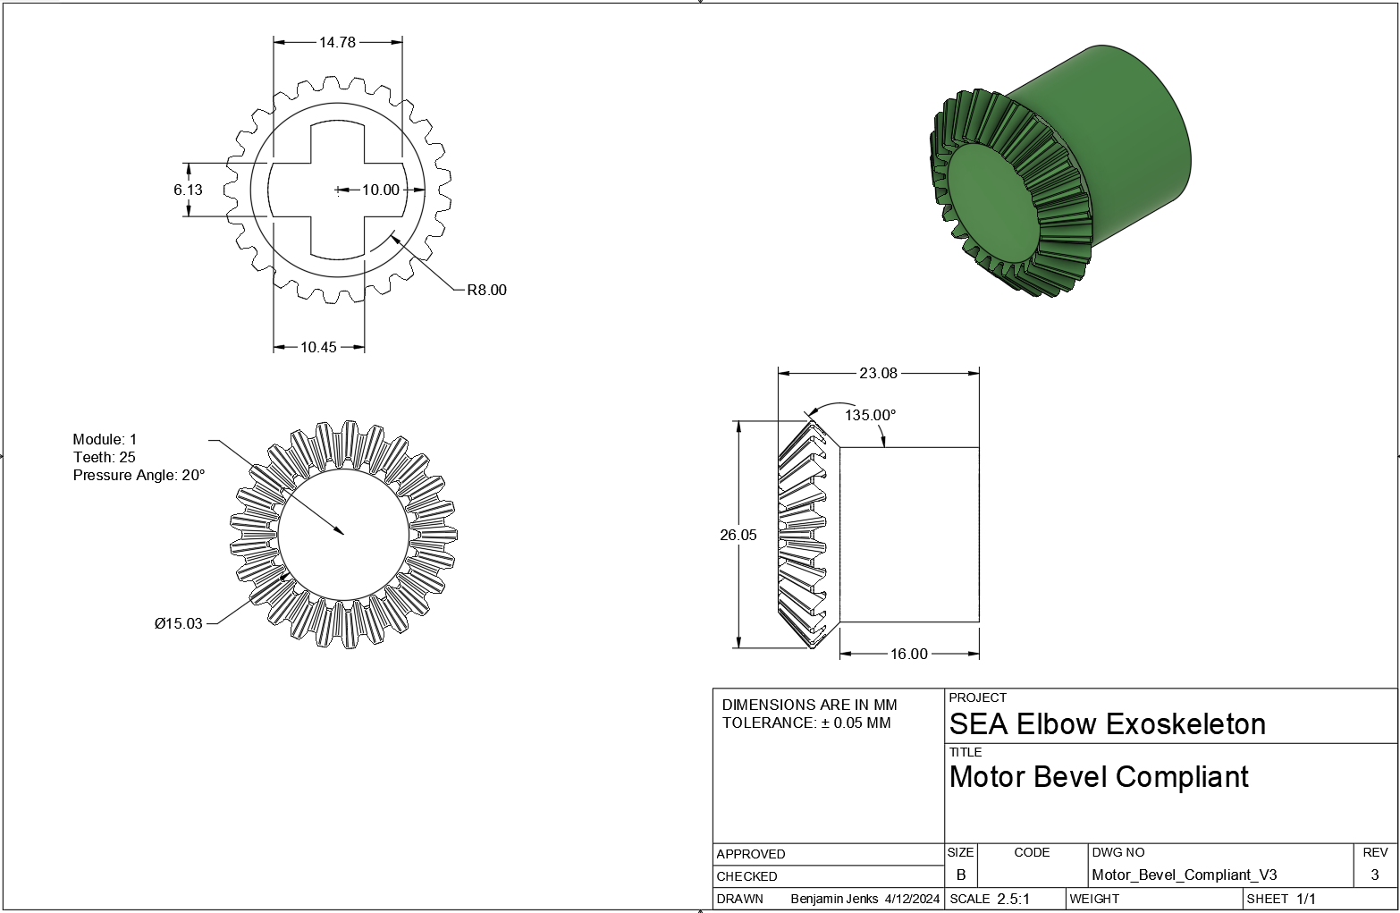
Photos/Schematics/Motor Bevel Compliant Drawing.png
