COMANDLab/SEA_Exoskeleton/Photos/Schematics/Motor Bevel Drawing.png

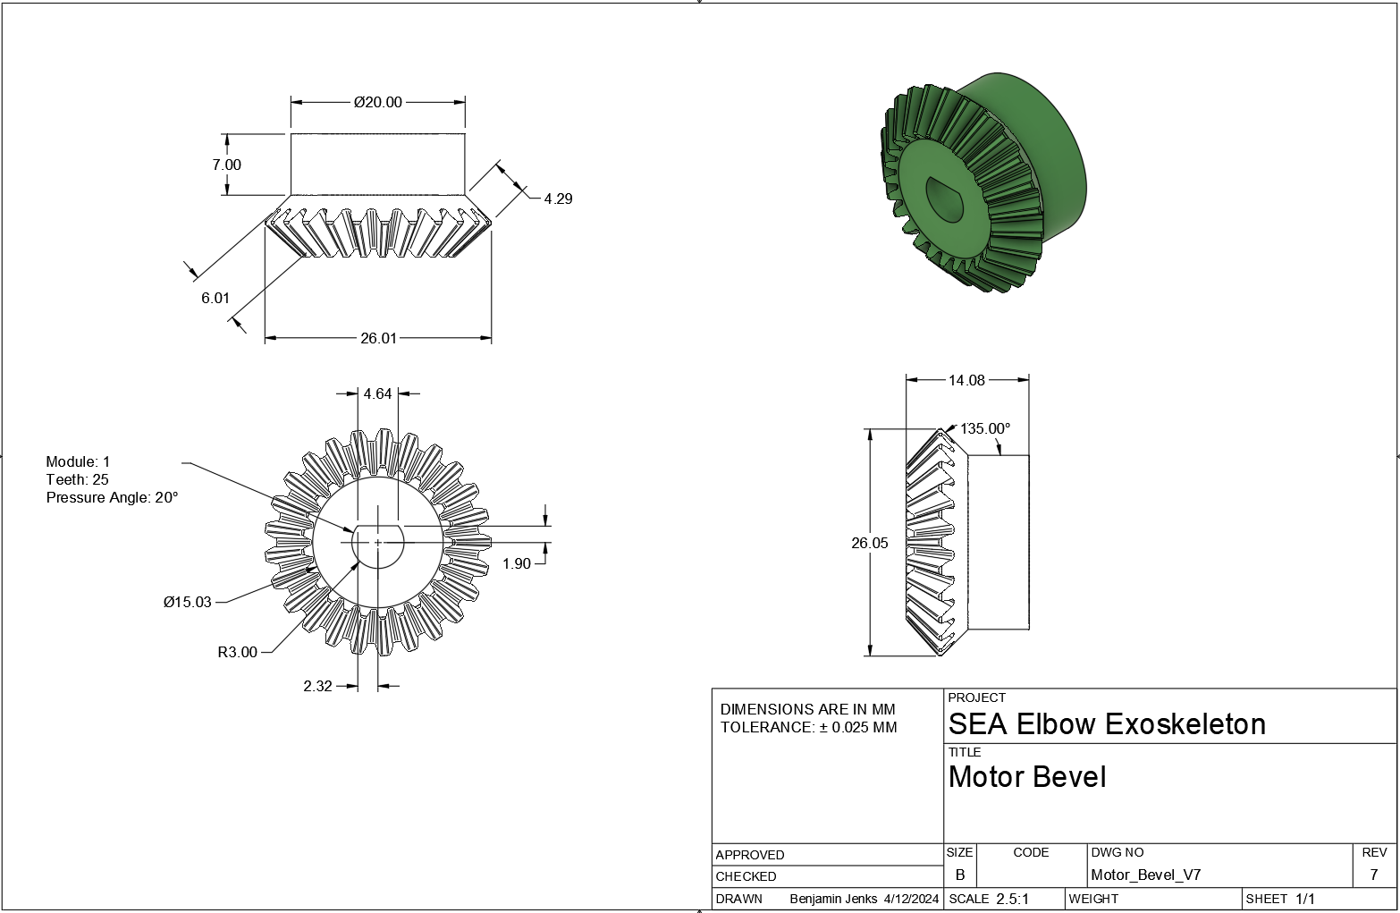
Photos/Schematics/Motor Bevel Drawing.png
