COMANDLab/SEA_Exoskeleton/Photos/Schematics/Motor Bracket Drawing.png

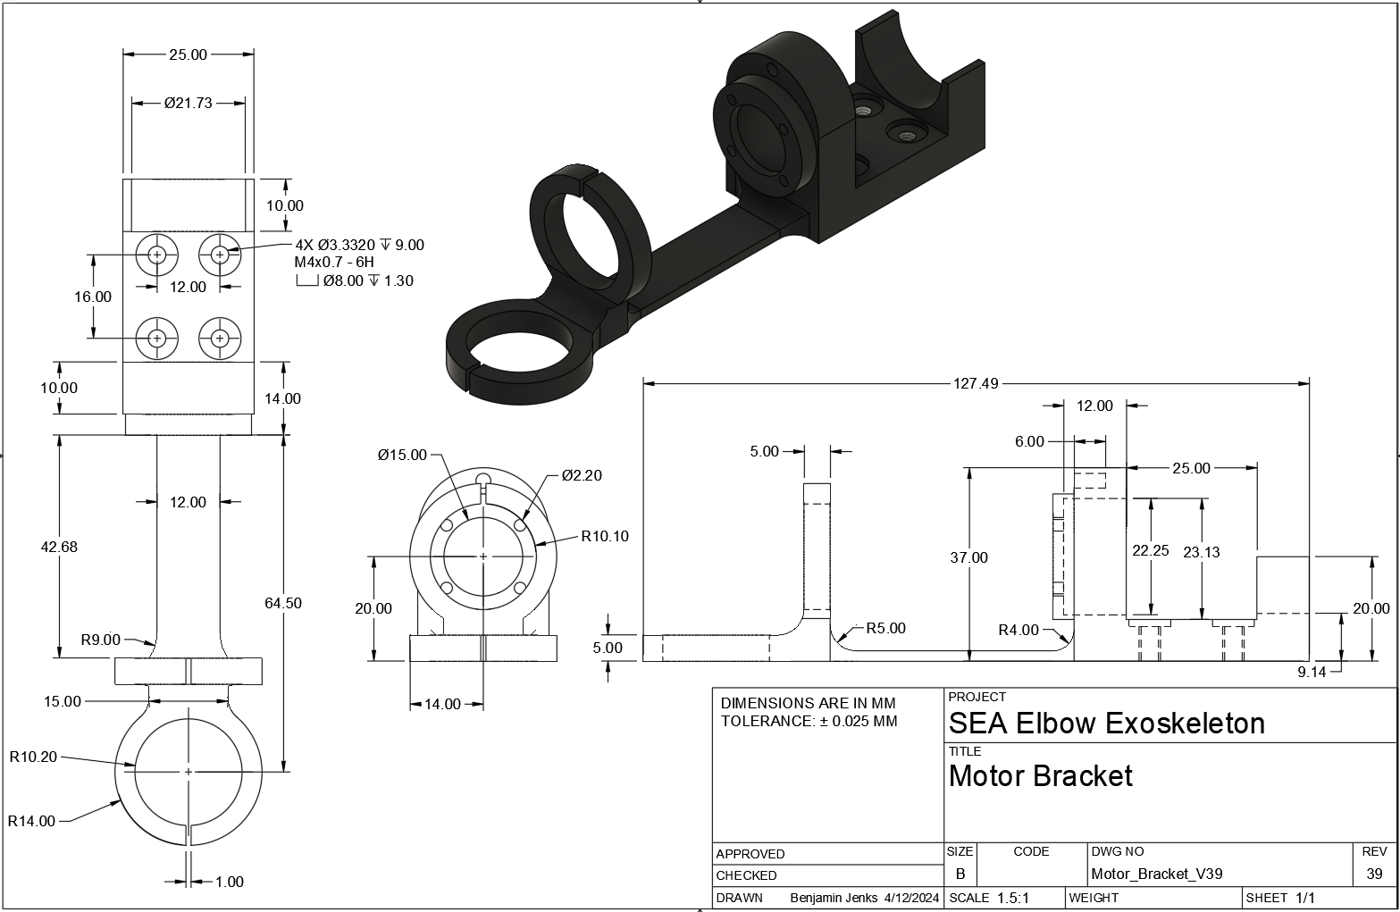
Photos/Schematics/Motor Bracket Drawing.png
