COMANDLab/SEA_Exoskeleton/Photos/Schematics/Planet Gear Drawing.png

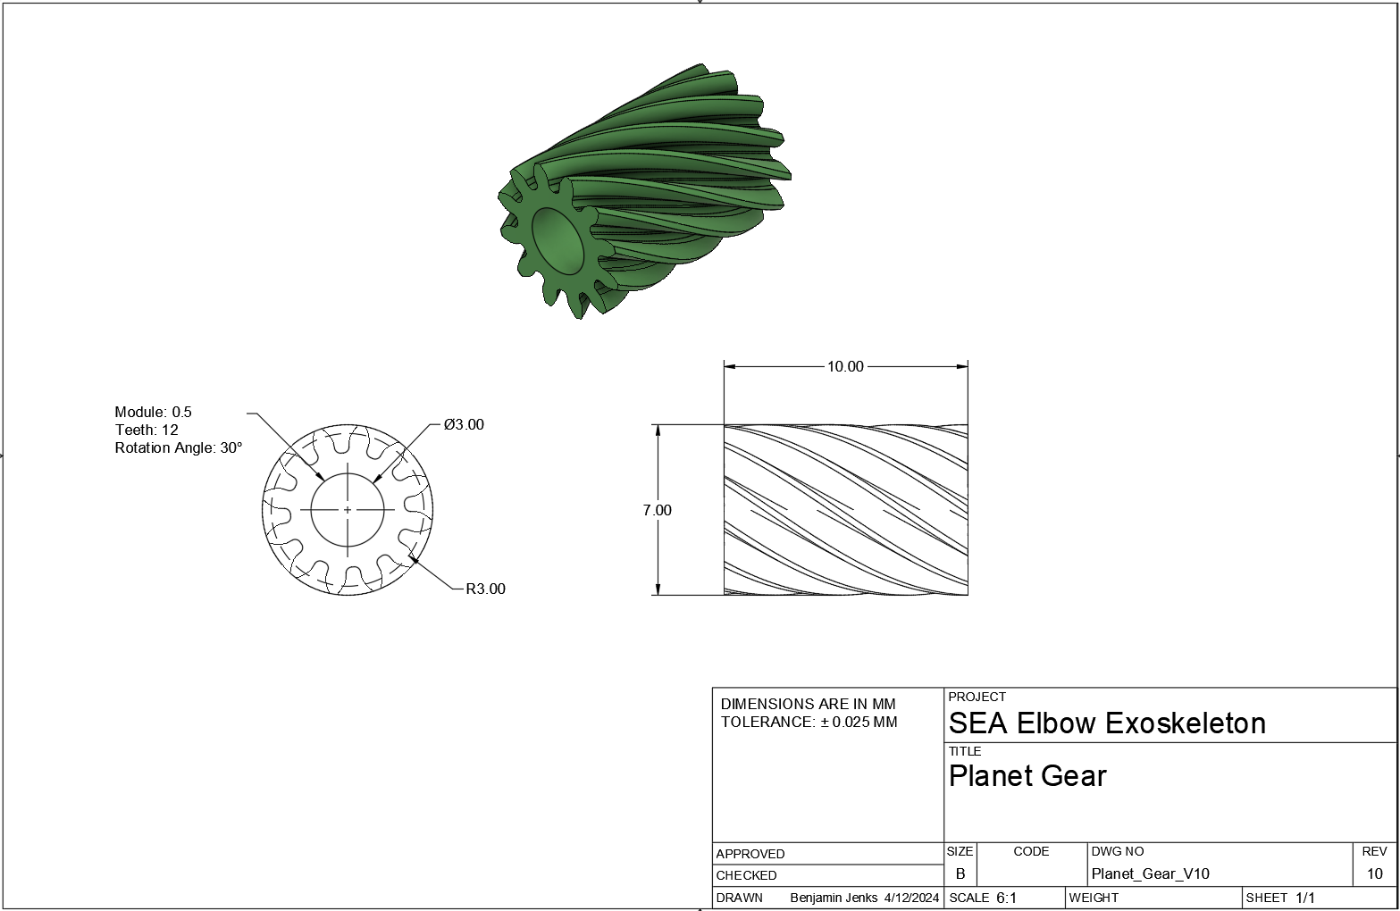
Photos/Schematics/Planet Gear Drawing.png
