COMANDLab/SEA_Exoskeleton/Photos/Schematics/Planet Stop Drawing.png

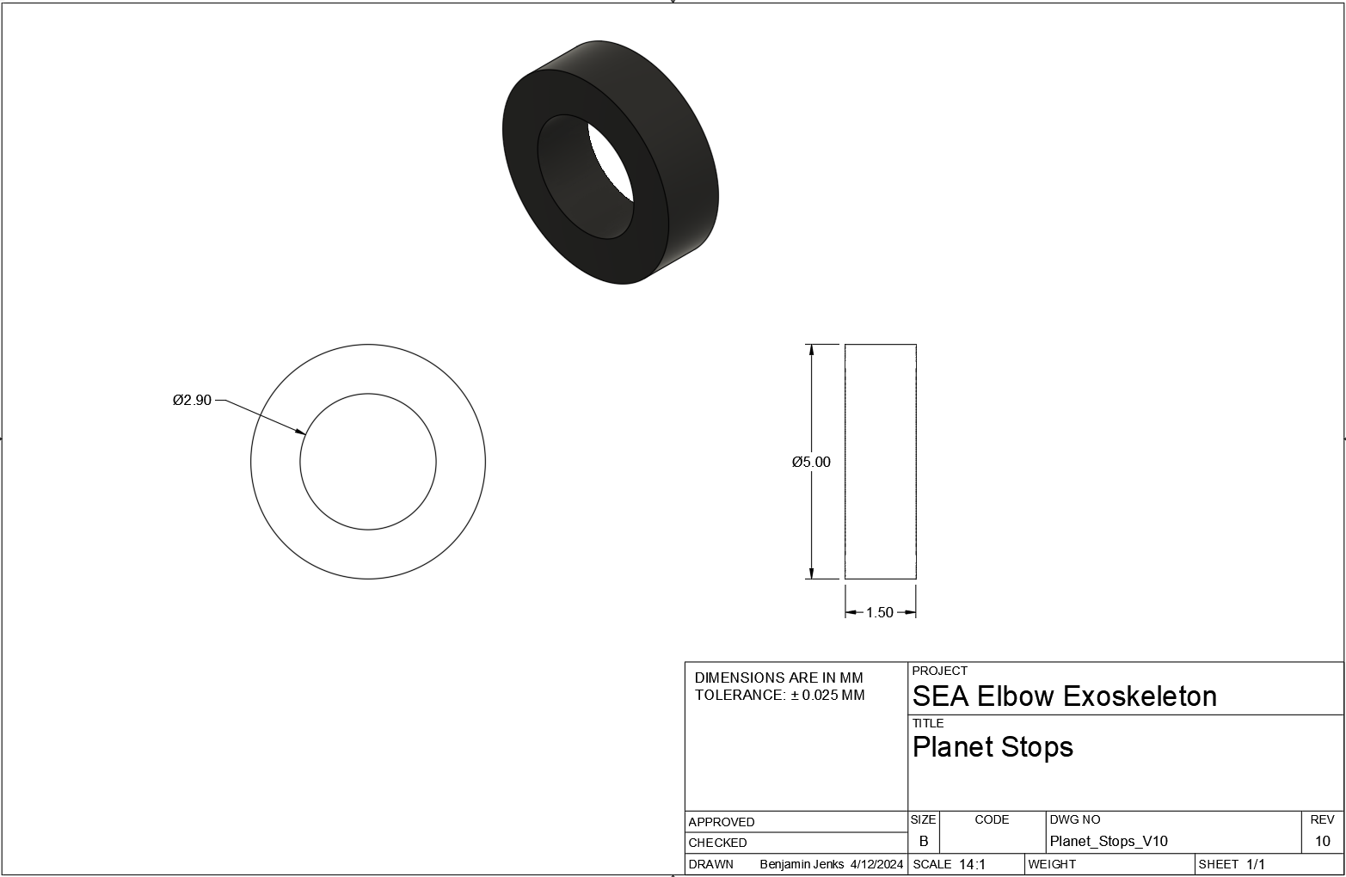
Photos/Schematics/Planet Stop Drawing.png
