COMANDLab/SEA_Exoskeleton/Photos/Schematics/Plus Coupler Drawing.png

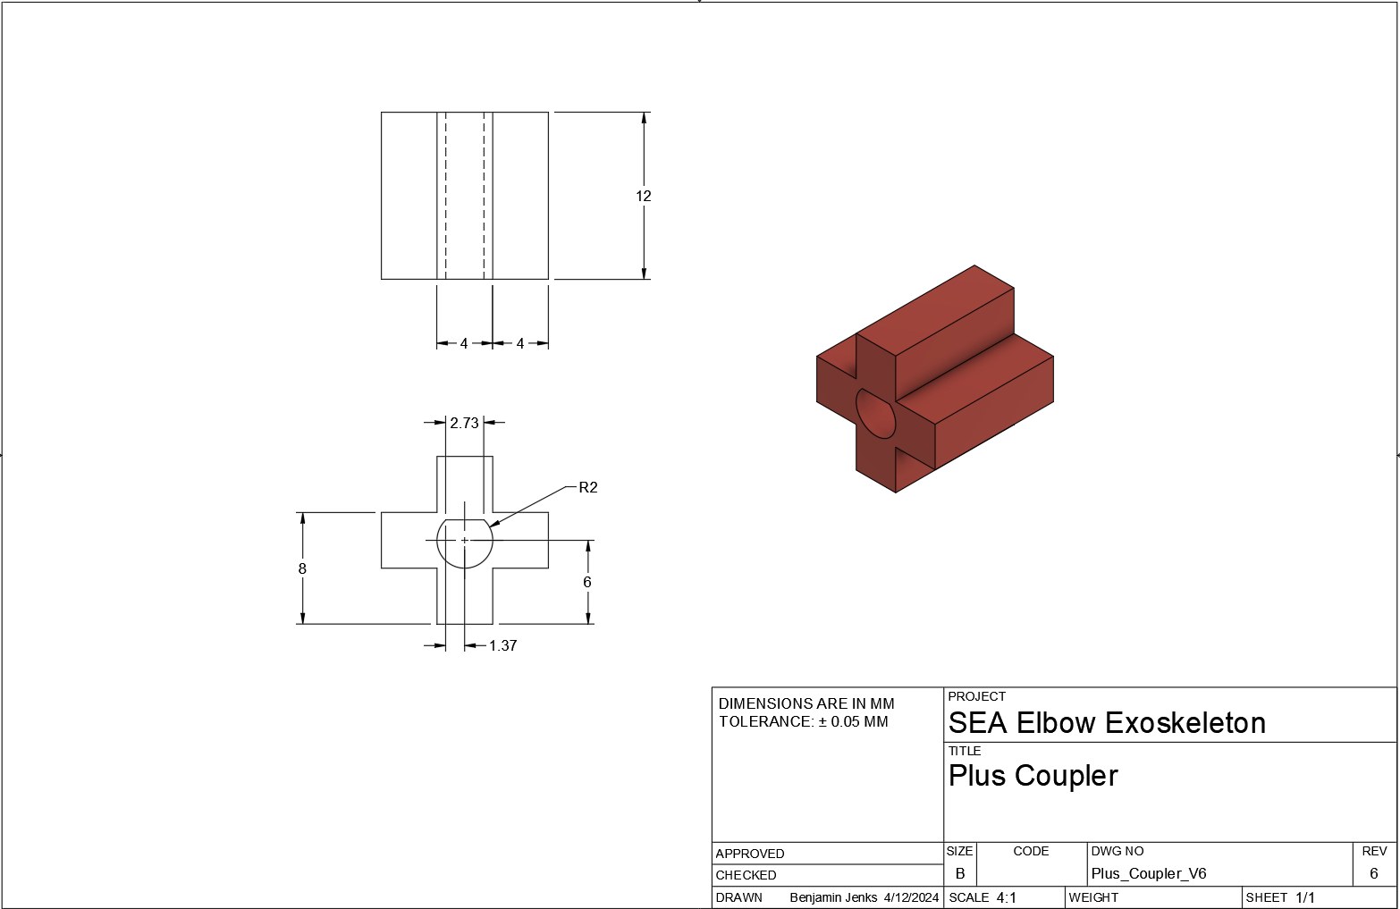
Photos/Schematics/Plus Coupler Drawing.png
