COMANDLab/SEA_Exoskeleton/Photos/Schematics/Ring Gear Drawing.png

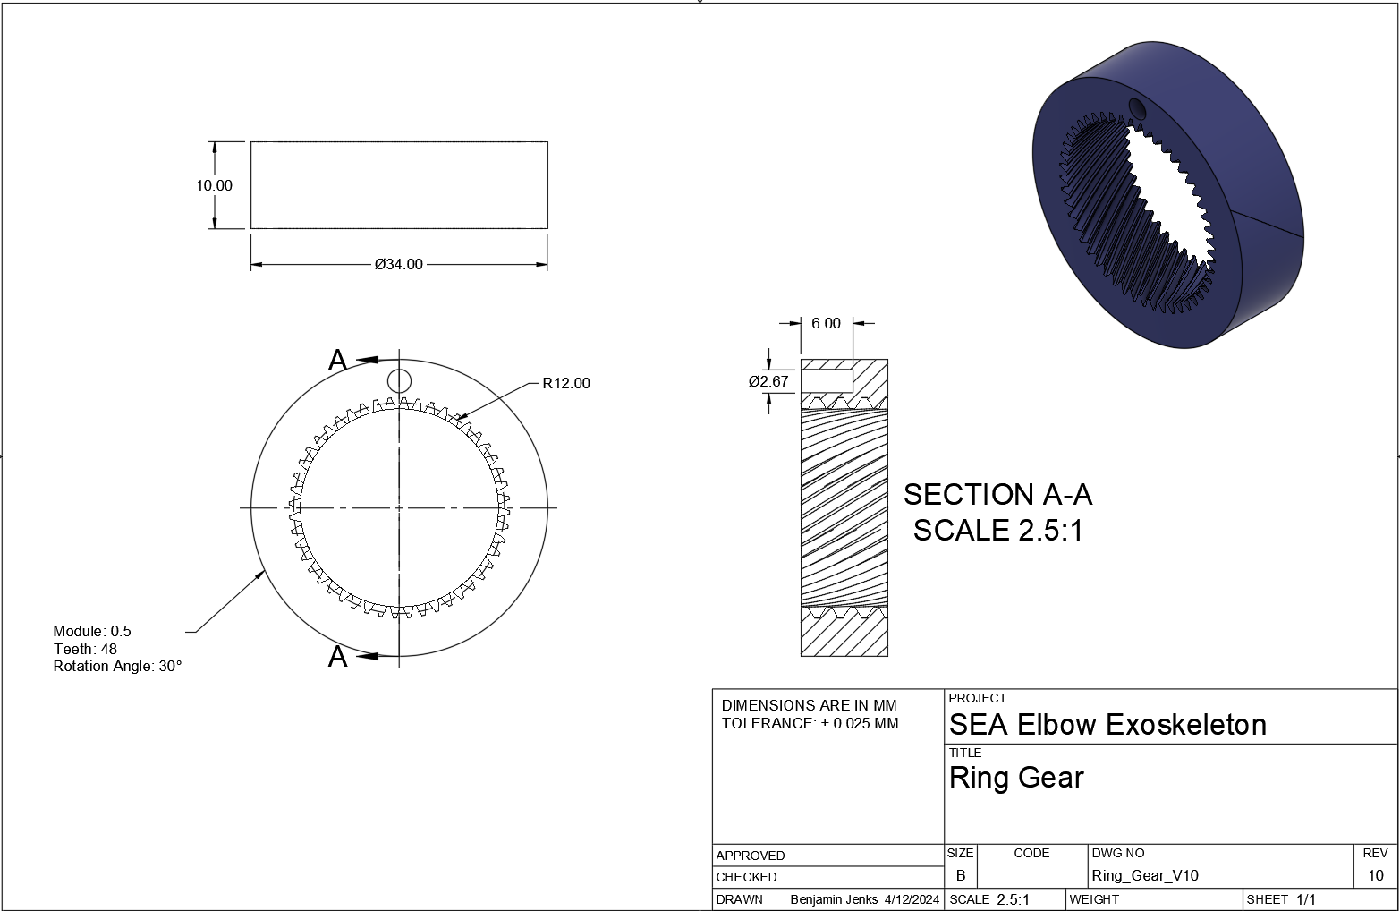
Photos/Schematics/Ring Gear Drawing.png
