COMANDLab/SEA_Exoskeleton/Photos/Schematics/Spring Specs and Redline.jpg

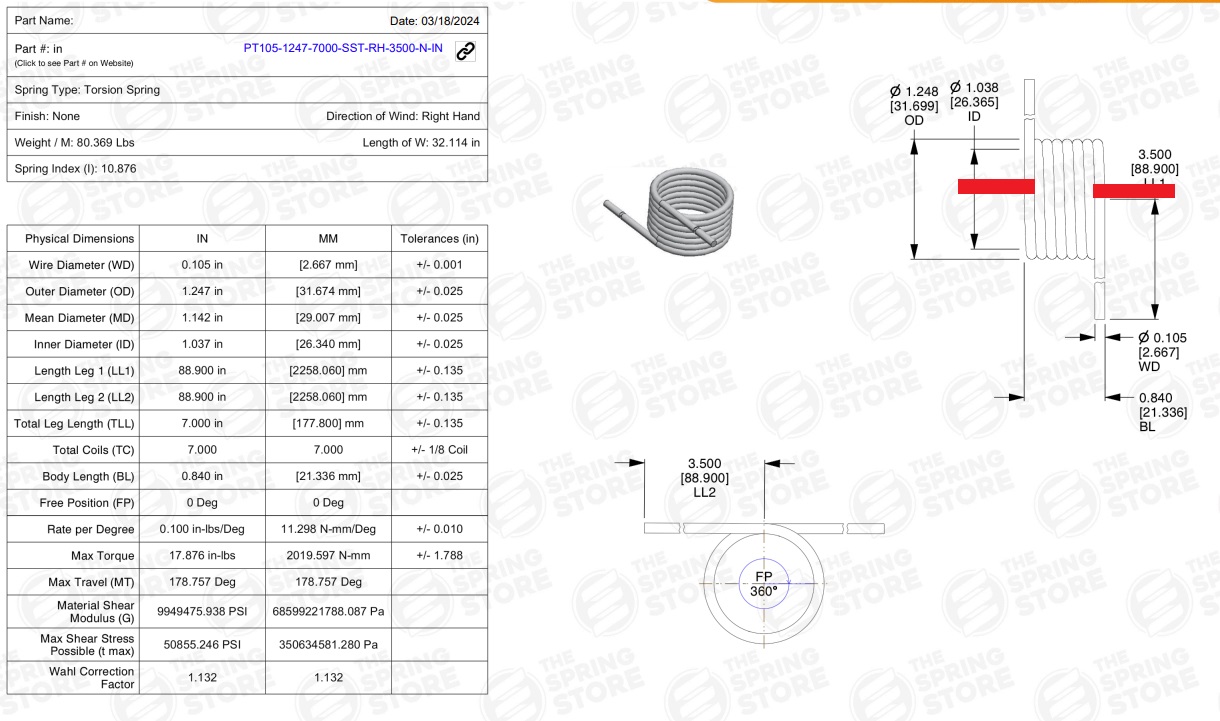
Photos/Schematics/Spring Specs and Redline.jpg
