COMANDLab/SEA_Exoskeleton/Photos/Schematics/Sun Gear Drawing.png

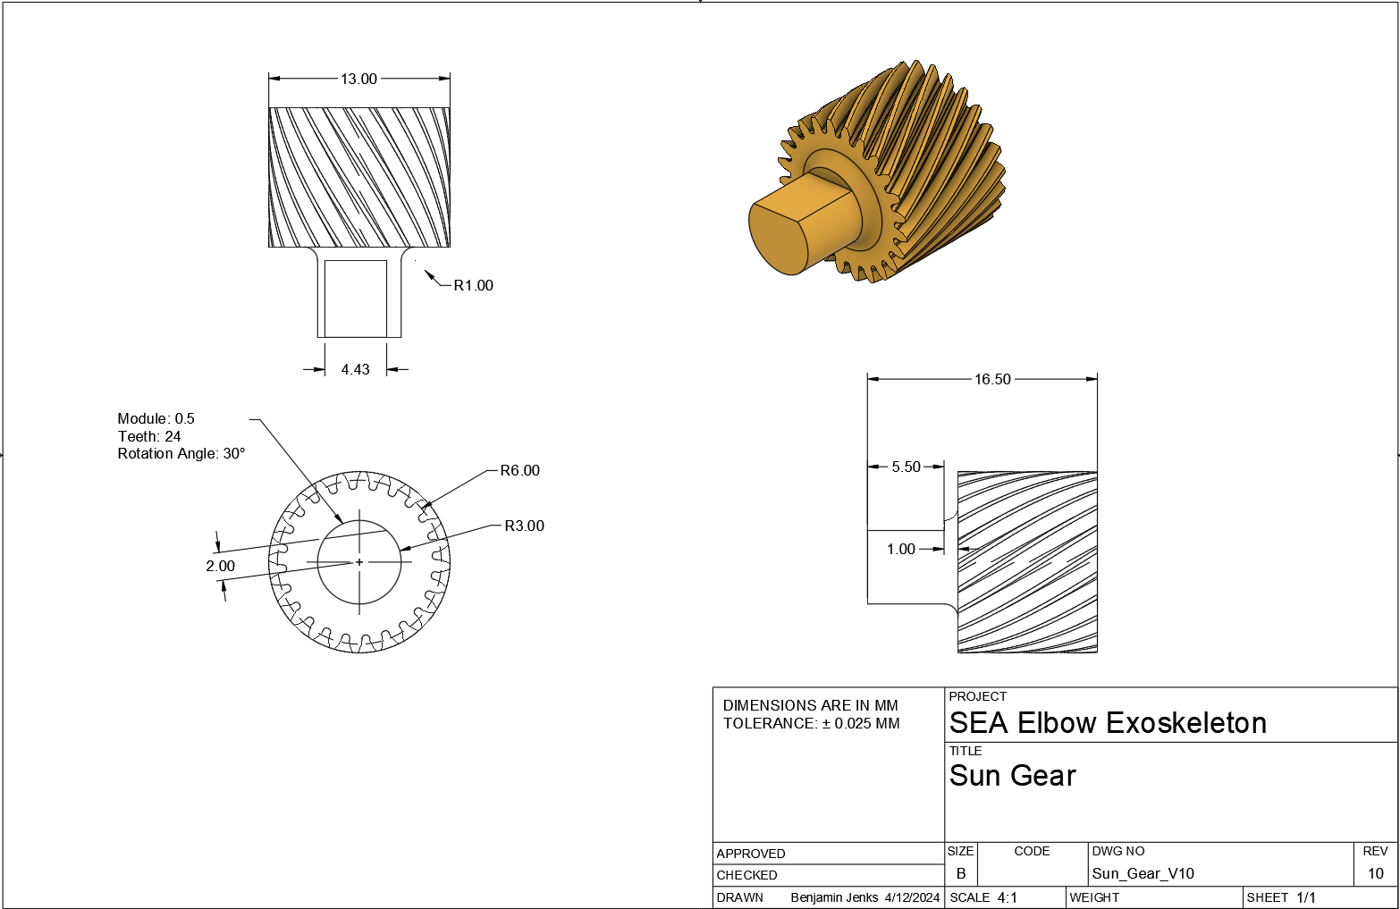
Photos/Schematics/Sun Gear Drawing.png
