COMANDLab/SEA_Exoskeleton/Photos/Spring Componenets.png

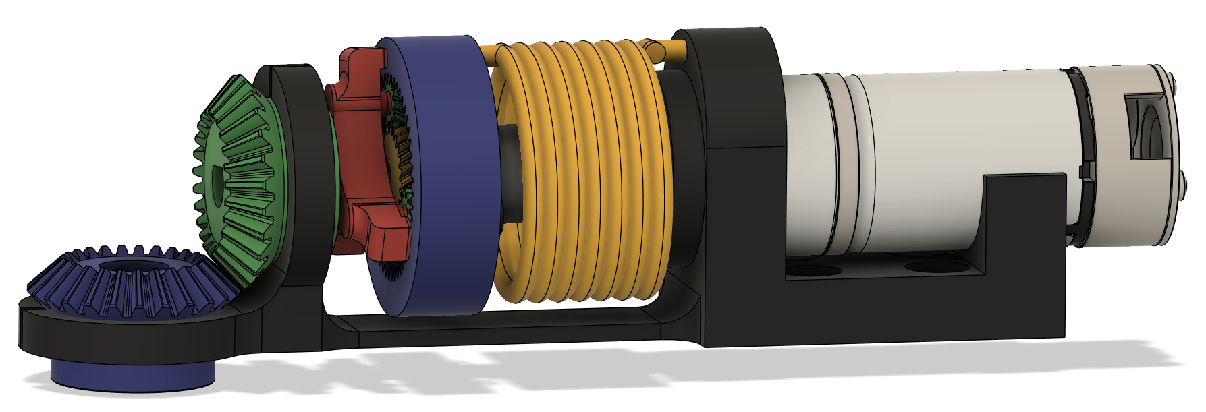
Photos/Spring Componenets.png
