COMANDLab/SEA_Exoskeleton/Photos/Spring side.png

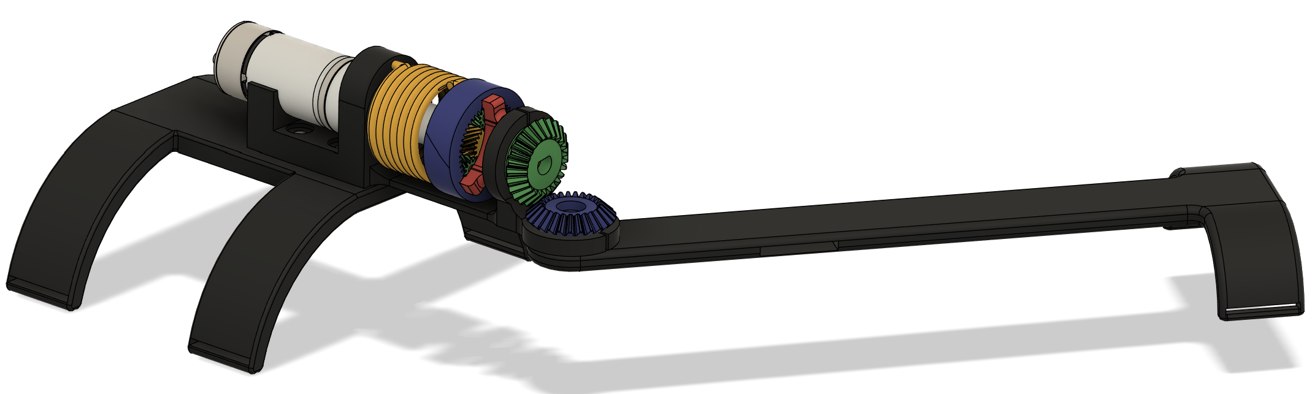
Photos/Spring side.png
