COMANDLab/SEA_Exoskeleton/Photos/Torque diagram.png

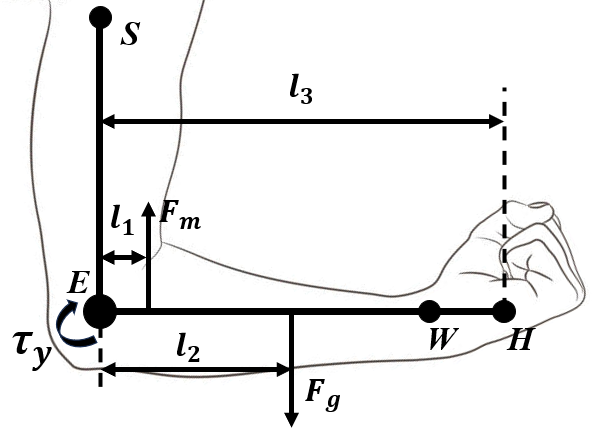
Photos/Torque diagram.png
