COMANDLab/SEA_Exoskeleton/Photos/torsion spring.png

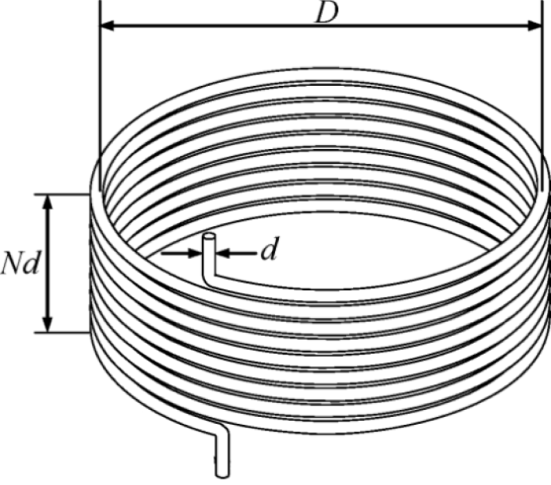
Photos/torsion spring.png
