COMANDLab/SEA_Exoskeleton/Photos/Compliant Components.png

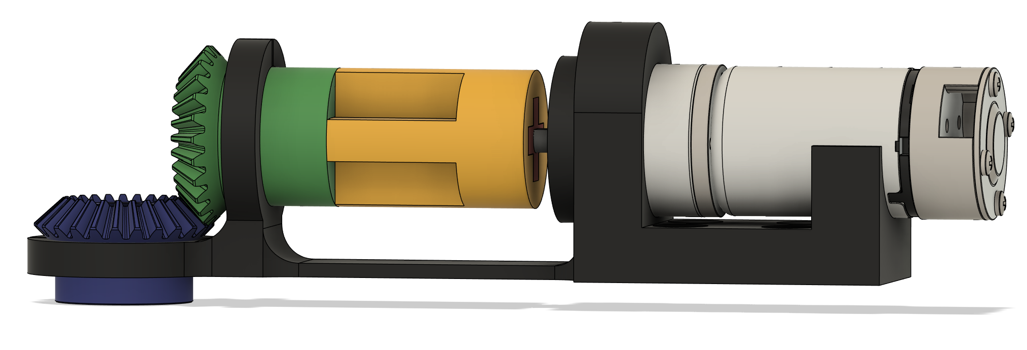
Photos/Compliant Components.png
