COMANDLab/SEA_Exoskeleton/Photos/Final Design Components Labeled.png

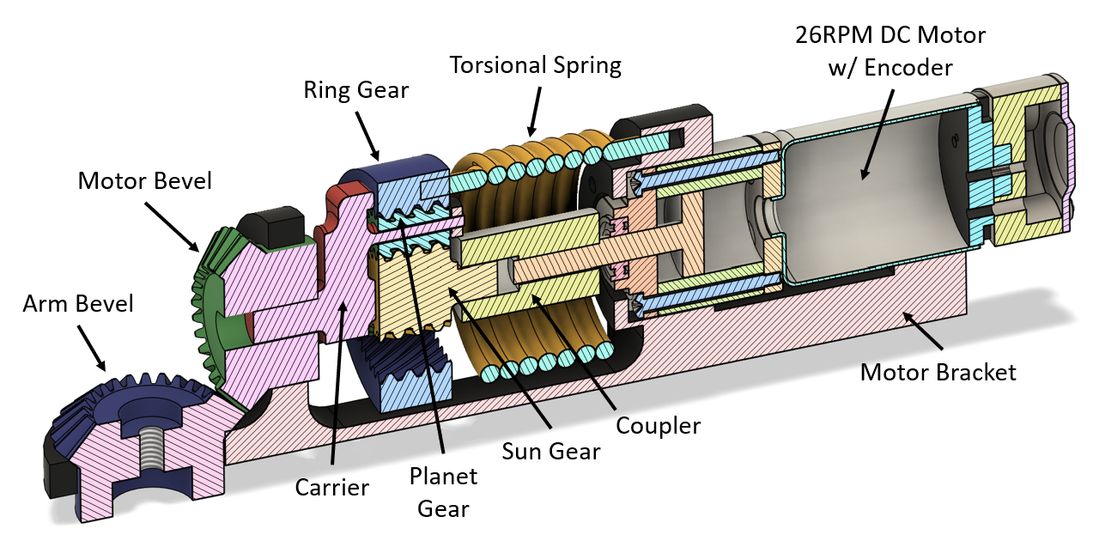
Photos/Final Design Components Labeled.png
