COMANDLab/SEA_Exoskeleton/STEP Files/Motor Bracket v40.step

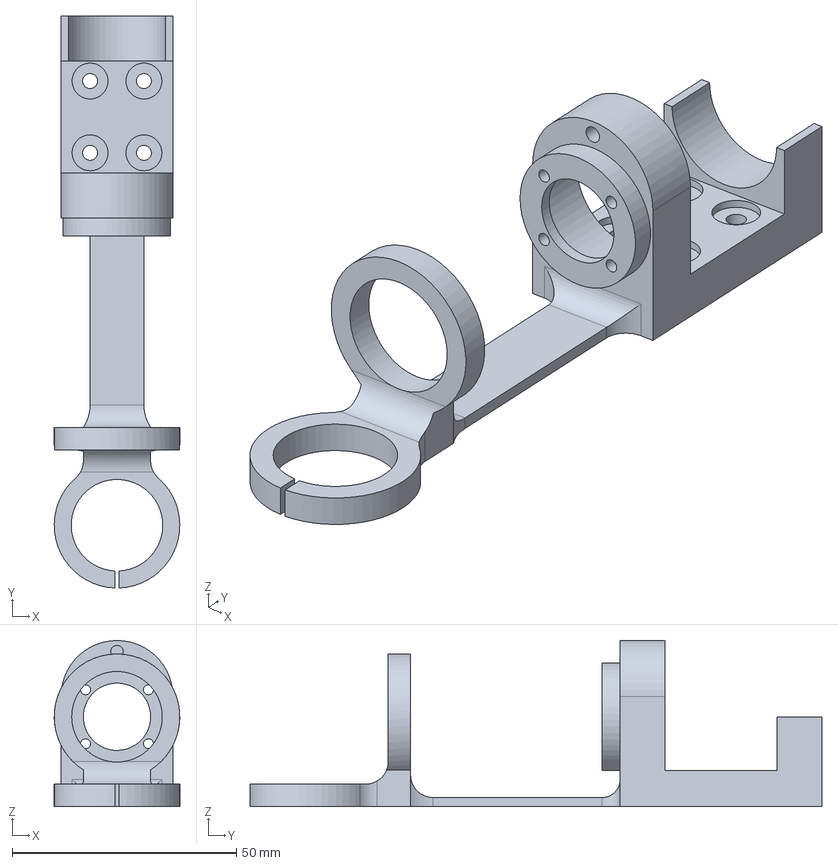
[picture p56: CAD file, 2024-06-05]
STEP Files/Motor Bracket v40.step
28.0 x 127.5 x 37.0 mm
