COMANDLab/SEA_Exoskeleton/STL/Ben_Compliant_Arm_2.3mf

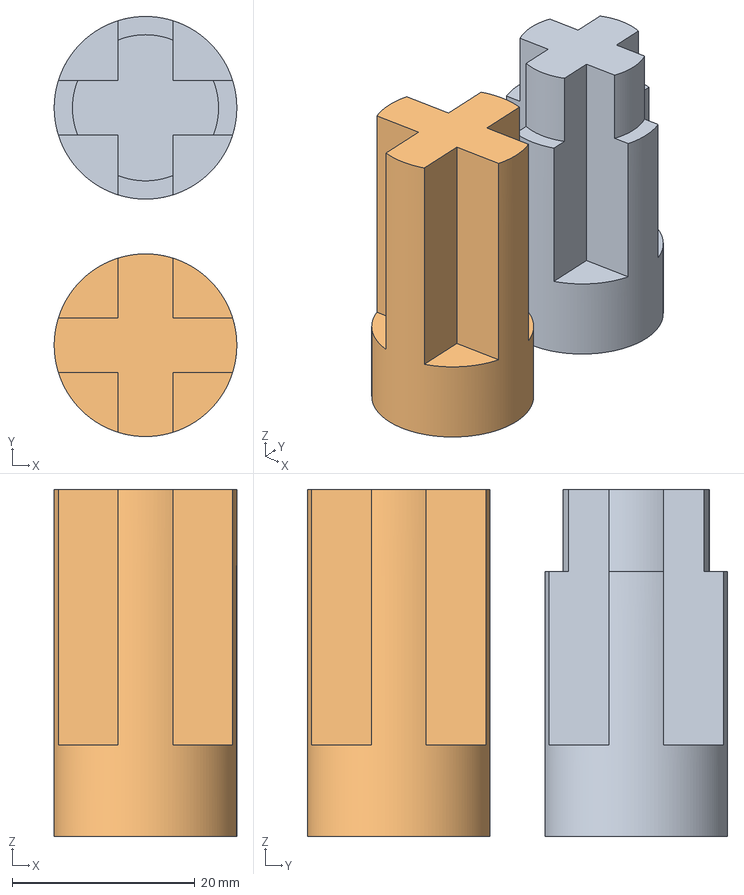
[picture p57: CAD file, 2024-04-18]
STL/Ben_Compliant_Arm_2.3mf
20.0 x 46.0 x 38.0 mm
Compliant Coupler Stepdown.stl
Compliant Coupler No Step Down.stl
