COMANDLab/SEA_Exoskeleton/STEP Files/Arm Bevel v6.step

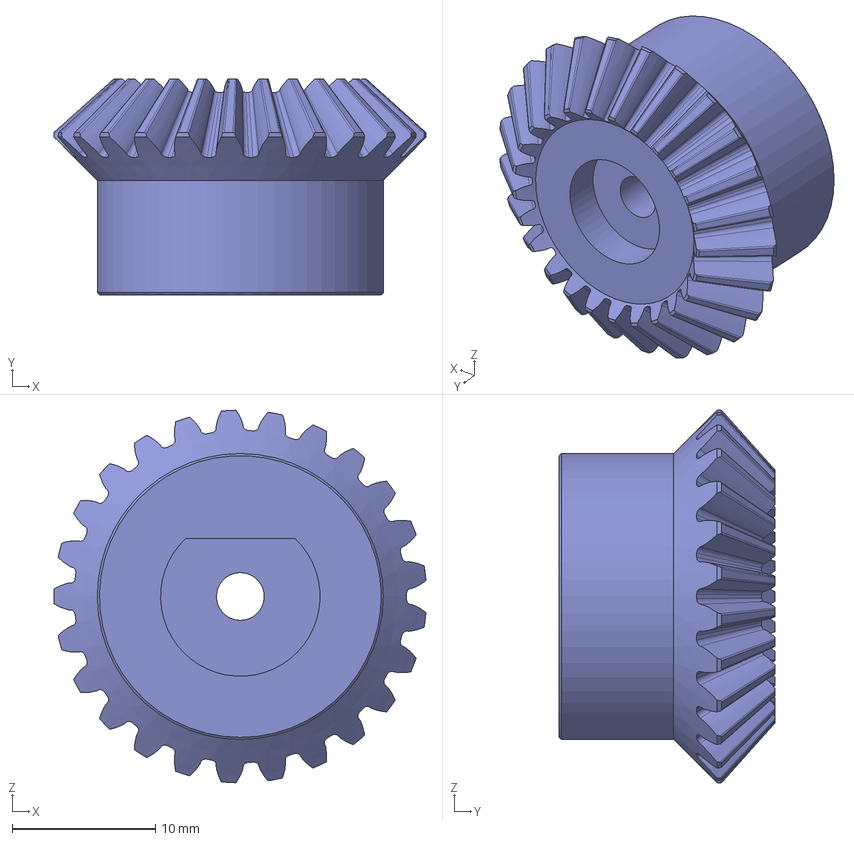
[picture p58: CAD file, 2024-04-17]
STEP Files/Arm Bevel v6.step
26.0 x 15.1 x 26.1 mm
