COMANDLab/SEA_Exoskeleton/STL/Planet Stop.stl

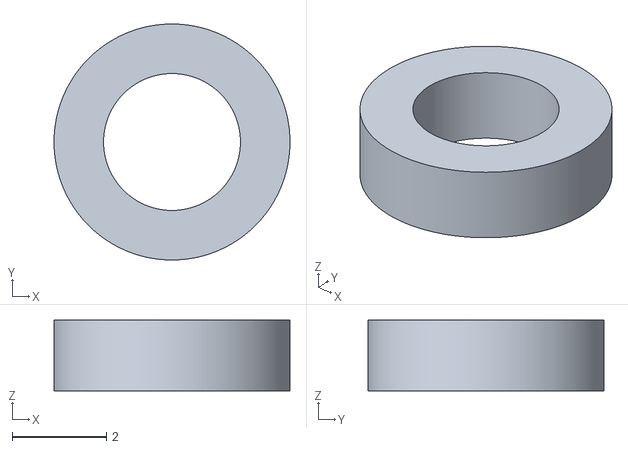
[picture p59: CAD file, 2024-04-17]
STL/Planet Stop.stl
5.00 x 5.00 x 1.50
