COMANDLab/SEA_Exoskeleton/STEP Files/Bicep v13.step

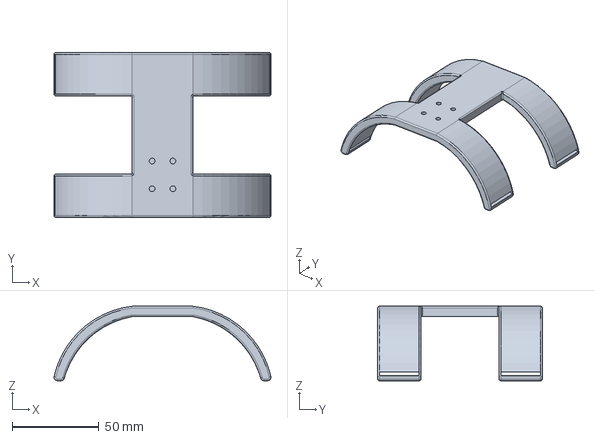
[picture p60: CAD file, 2024-04-17]
STEP Files/Bicep v13.step
125.1 x 95.0 x 43.0 mm
