COMANDLab/SEA_Exoskeleton/STEP Files/Plus Coupler v6.step

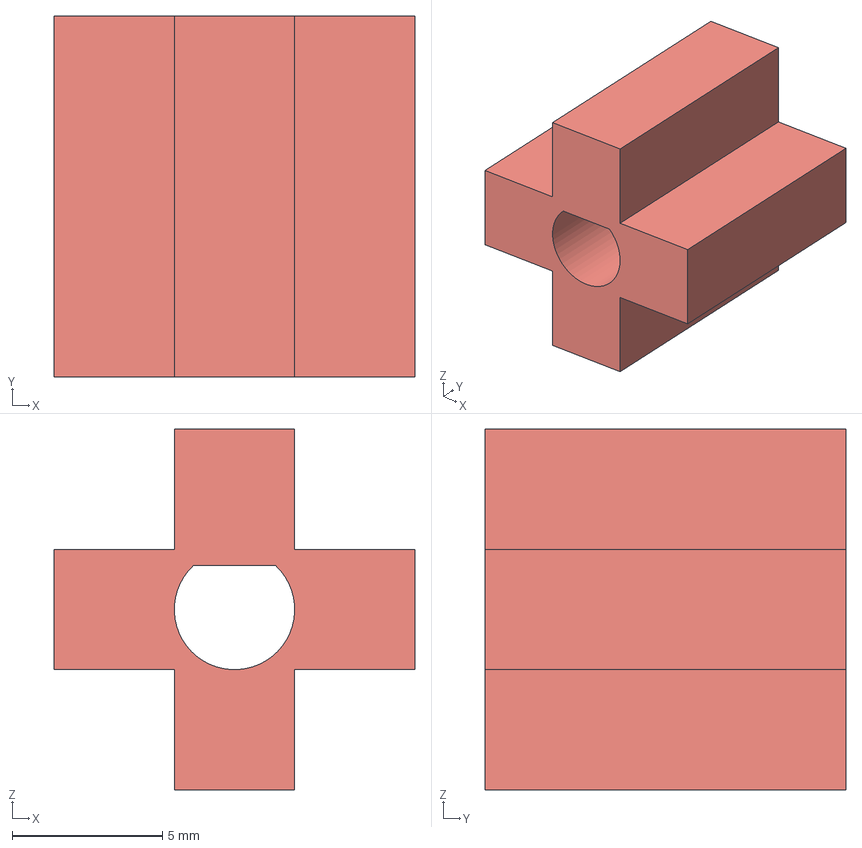
[picture p61: CAD file, 2024-04-17]
STEP Files/Plus Coupler v6.step
12.0 x 12.0 x 12.0 mm
