COMANDLab/SEA_Exoskeleton/STEP Files/Forearm v22.step

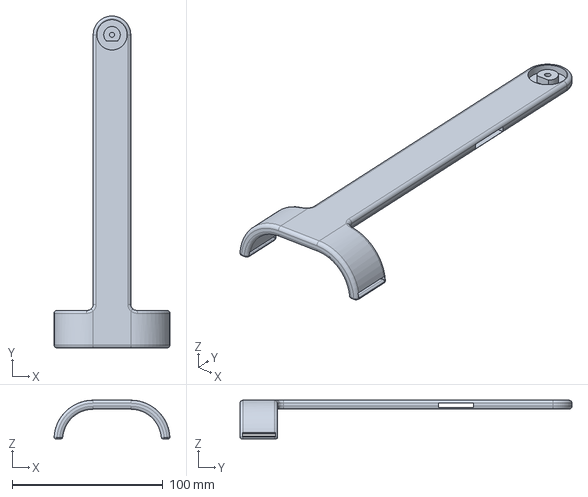
[picture p62: CAD file, 2024-04-17]
STEP Files/Forearm v22.step
77.0 x 220.5 x 25.6 mm
