COMANDLab/SEA_Exoskeleton/STL/Arm.stl

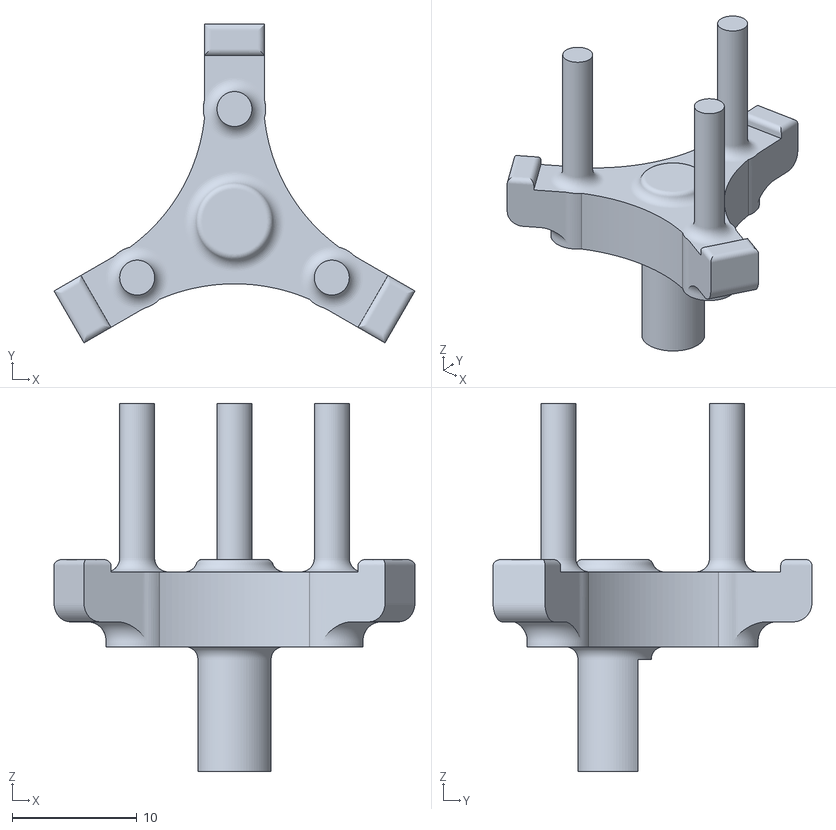
[picture p63: CAD file, 2024-04-17]
STL/Arm.stl
28.9 x 25.5 x 29.5
