COMANDLab/SEA_Exoskeleton/STEP Files/Motor Bevel Compliant v3.step

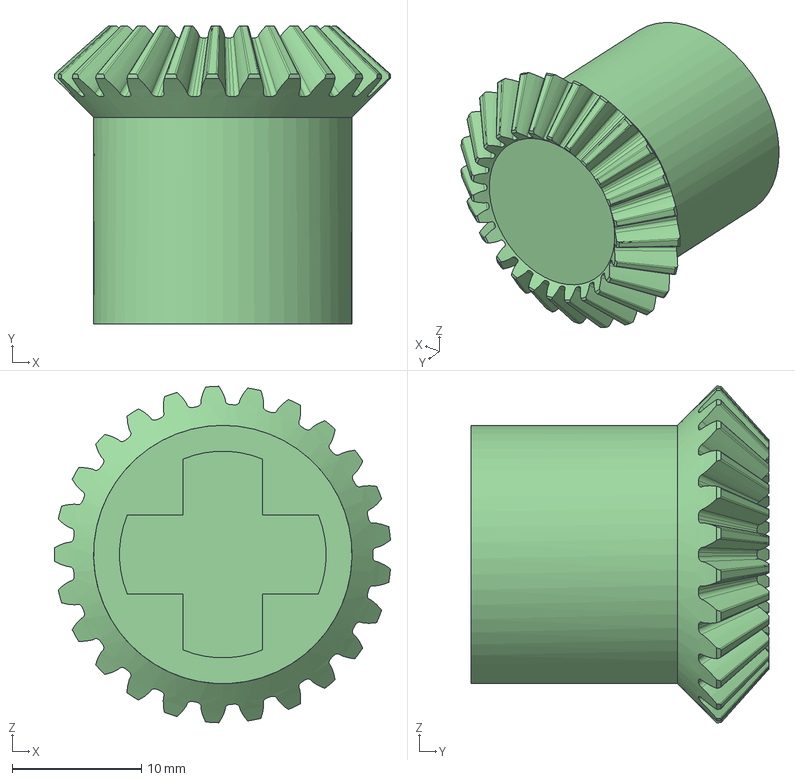
[picture p64: CAD file, 2024-04-17]
STEP Files/Motor Bevel Compliant v3.step
26.0 x 23.1 x 26.1 mm
