COMANDLab/SEA_Exoskeleton/STL/Coupler.stl

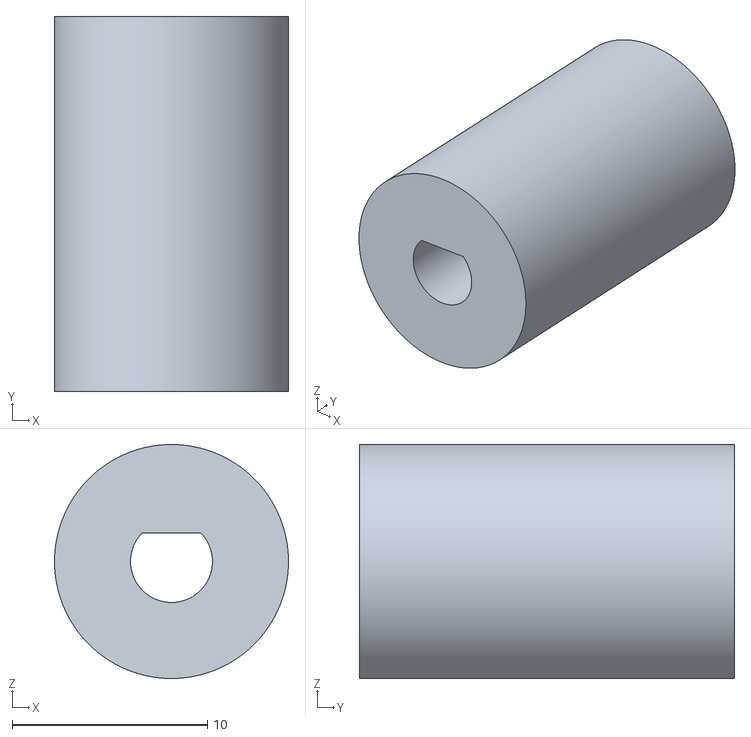
[picture p65: CAD file, 2024-04-17]
STL/Coupler.stl
12.0 x 19.2 x 12.0
