COMANDLab/SEA_Exoskeleton/STEP Files/Spring v4.step

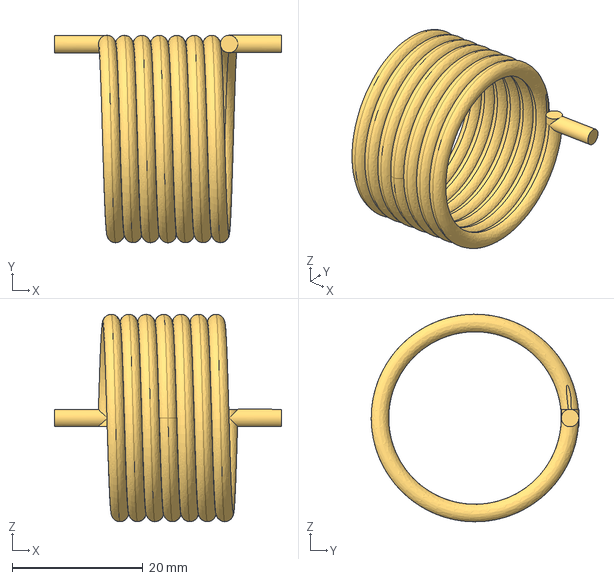
[picture p66: CAD file, 2024-04-17]
STEP Files/Spring v4.step
34.7 x 31.7 x 31.7 mm
