COMANDLab/SEA_Exoskeleton/STEP Files/Compliant Arm v3.step

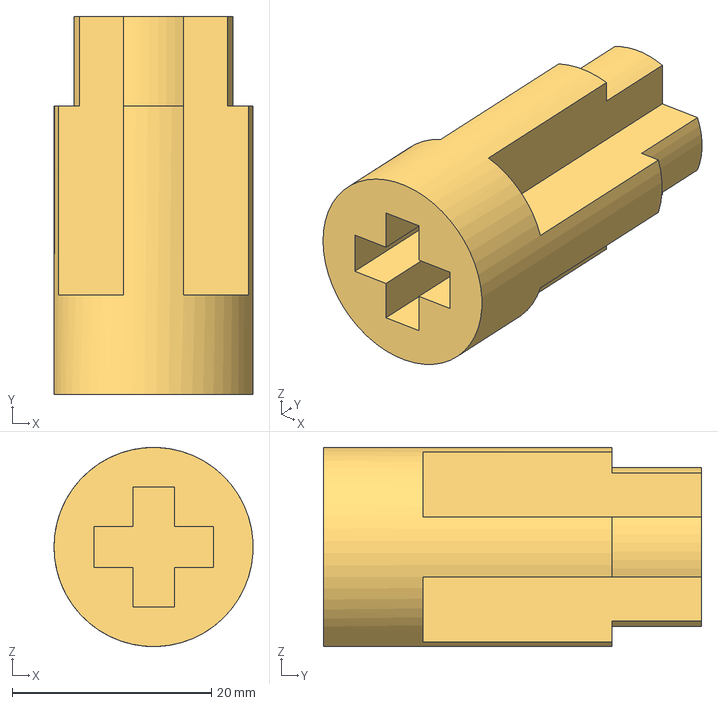
[picture p67: CAD file, 2024-04-17]
STEP Files/Compliant Arm v3.step
20.0 x 38.0 x 20.0 mm
