COMANDLab/SEA_Exoskeleton/STEP Files/Motor Bevel v7.step

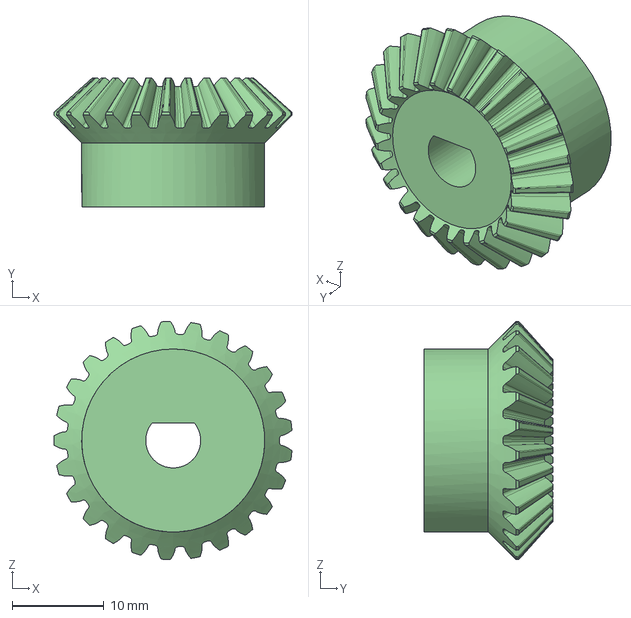
[picture p68: CAD file, 2024-04-17]
STEP Files/Motor Bevel v7.step
26.0 x 14.1 x 26.1 mm
