COMANDLab/SEA_Exoskeleton/STL/Forearm Cuff.stl

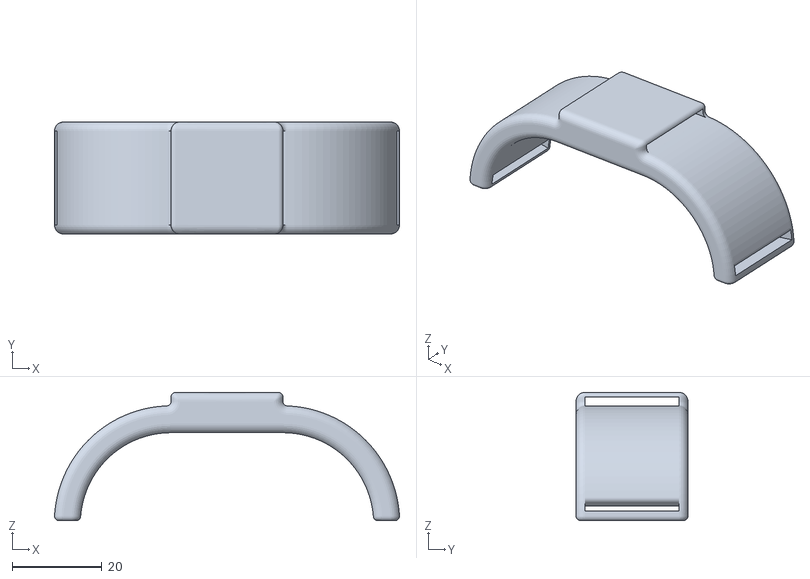
[picture p69: CAD file, 2024-04-17]
STL/Forearm Cuff.stl
77.0 x 25.0 x 28.6
