COMANDLab/SEA_Exoskeleton/(list of files, cad)

Other CAD files:
STL/Motor Bracket.stl
STL/Motor Bevel.stl
STL/Plus Coupler.stl
STL/Bicep.stl
STL/Compliant Coupler Stepdown.stl
STL/Arm Bevel.stl
STEP Files/Coupler v9.step
STL/Forearm.stl
STL/Bevel Coupler StepDown.stl
