COMANDLab/SEA_Exoskeleton/Data/Dynamic Test/Dynamic Test Results.xlsx

Sheet: Higher Frequency
Voltage (V) | Max Forearm Speed (rad/s) | Omega at Peak Angle (rad/s) | Overshoot (deg) | Oscillation Amplitude (deg) | Final Angle (deg) | % Overshoot | Settling Time (s) | Damping Ratio | Natural Frequency (rad/s)
12 | -1.94 | -0.04 | -0.1518 | -0.1662 | -49.6067 | 0.3061 | 0.0871 | 0.8789 | 52.25
12 | -1.79 | 0.02 | -0.1948 | -0.1948 | -42.5794 | 0.4575 | 0.0895 | 0.8638 | 51.74
12 | -1.84 | -0.04 | -0.0745 | -0.0745 | -40.3448 | 0.1846 | 0.0465 | 0.8948 | 96.14
12 | -1.75 | 0.02 | -0.0086 | -0.0086 | -40.3477 | 0.0213 | 0.0278 | 0.9374 | 153.50
12 | -1.91 | 0.03 | -0.0258 | -0.0258 | -42.8716 | 0.0601 | 0.0417 | 0.9208 | 104.17
14 | -2.2 | 0.06 | -0.4927 | -0.5414 | -42.8802 | 1.1491 | 0.1723 | 0.8179 | 28.38
14 | -2.24 | -0.16 | -0.55 | -0.6016 | -43.9315 | 1.252 | 0.1992 | 0.8126 | 24.71
14 | -2.02 | -0.07 | -0.4985 | -0.5128 | -43.1724 | 1.1546 | 0.2244 | 0.8176 | 21.80
14 | -2.53 | -0.01 | -0.1404 | -0.1576 | -49.6411 | 0.2828 | 0.0916 | 0.8816 | 49.53
14 | -2.81 | 0.06 | -0.0688 | -0.0688 | -43.5677 | 0.1578 | 0.1043 | 0.8991 | 42.66
16 | -2.97 | -0.03 | -0.6274 | -0.6589 | -47.8849 | 1.3102 | 0.2113 | 0.8097 | 23.38
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
