COMANDLab/SEA_Exoskeleton/Data/Dynamic Test/Excel Data Files/1_12V.xlsx

time | forearm x | forearm y | forearm z | upper x | upper y | upper z | motor time | position
0.04 | 0.1 | -0.16 | 0 | 0.08 | -0.13 | 0.02 | 4.57 | 0
0.05 | 0.1 | -0.16 | 0 | 1.37 | -1.18 | 0.54 | 4.59 | 1
0.05 | 0.02 | -0.04 | 0 | 1.37 | -1.18 | 0.54 | 4.6 | 3
0.06 | 0.01 | -0.04 | 0 | 0.66 | -1.37 | -0.18 | 4.62 | 8
0.07 | 0.01 | -0.03 | 0 | 0.05 | -0.1 | -0.03 | 4.63 | 15
0.07 | 0.01 | -0.03 | 0 | 0.02 | -0.03 | -0.02 | 4.65 | 24
0.08 | 0.01 | -0.02 | 0 | 0.02 | -0.03 | -0.02 | 4.67 | 34
0.09 | 0.01 | -0.02 | 0 | 0.02 | -0.03 | -0.02 | 4.69 | 44
0.1 | 0.01 | -0.03 | 0.01 | 0.02 | -0.03 | -0.02 | 4.7 | 54
0.1 | 0.01 | -0.03 | 0.01 | 0.02 | -0.03 | -0.02 | 4.72 | 64
0.11 | 0.01 | -0.03 | 0.01 | 0.02 | -0.03 | -0.02 | 4.74 | 74
0.12 | 0.01 | -0.04 | 0 | 0.02 | -0.03 | -0.02 | 4.75 | 84
0.12 | 0.01 | -0.03 | 0 | 0.02 | -0.03 | -0.02 | 4.77 | 94
0.13 | 0.01 | -0.03 | 0 | 0.02 | -0.03 | -0.02 | 4.79 | 103
0.14 | 0.01 | -0.03 | 0.01 | 0.02 | -0.03 | -0.02 | 4.8 | 114
0.14 | 0.01 | -0.02 | 0 | 0.02 | -0.03 | -0.02 | 4.82 | 125
0.15 | 0.01 | -0.02 | -0.01 | 0.02 | -0.03 | -0.02 | 4.84 | 135
0.16 | 0.01 | -0.03 | 0 | 0.02 | -0.03 | -0.02 | 4.86 | 146
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
