COMANDLab/SEA_Exoskeleton/Data/Dynamic Test/Excel Data Files/1_14V.xlsx

time | forearm x | forearm y | forearm z | upper x | upper y | upper z | motor time | position
0.04 | -0.05 | 0.11 | 0.06 | 0.32 | -0.1 | 0.13 | 12.22 | 0
0.05 | -0.05 | 0.11 | 0.06 | 0.47 | -0.4 | -0.06 | 12.24 | 0
0.05 | -0.19 | 0.37 | 0.09 | 0.47 | -0.4 | -0.06 | 12.26 | 0
0.06 | -0.17 | 0.35 | 0.08 | -0.08 | 0.45 | 0.01 | 12.27 | 0
0.07 | -0.12 | 0.27 | 0.05 | -0.14 | 0.45 | 0.05 | 12.29 | 0
0.07 | -0.12 | 0.27 | 0.05 | -0.08 | 0.24 | 0.03 | 12.31 | 0
0.08 | -0.01 | 0.02 | 0.01 | -0.08 | 0.24 | 0.03 | 12.32 | 0
0.09 | 0.01 | -0.04 | 0 | 0.01 | -0.02 | -0.02 | 12.34 | 0
0.1 | 0.01 | -0.04 | 0 | 0.02 | -0.03 | -0.02 | 12.36 | 0
0.1 | 0.01 | -0.04 | 0 | 0.02 | -0.03 | -0.02 | 12.37 | 0
0.11 | 0.01 | -0.04 | 0 | 0.02 | -0.03 | -0.02 | 12.39 | 0
0.12 | 0.01 | -0.03 | 0 | 0.02 | -0.03 | -0.02 | 12.41 | 0
0.12 | 0.01 | -0.02 | 0 | 0.02 | -0.03 | -0.02 | 12.42 | 0
0.13 | 0.01 | -0.02 | 0 | 0.02 | -0.03 | -0.02 | 12.44 | 0
0.14 | 0.01 | -0.02 | 0 | 0.02 | -0.03 | -0.02 | 12.46 | 0
0.14 | 0.01 | -0.03 | 0 | 0.02 | -0.03 | -0.02 | 12.48 | 0
0.15 | 0.01 | -0.03 | 0 | 0.02 | -0.03 | -0.02 | 12.49 | 0
0.16 | 0.01 | -0.04 | 0 | 0.02 | -0.03 | -0.02 | 12.51 | 0
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
