COMANDLab/SEA_Exoskeleton/Data/Dynamic Test/Excel Data Files/1_16V.xlsx

time | forearm x | forearm y | forearm z | upper x | upper y | upper z | motor time | position
0.04 | -0.05 | 0.11 | 0.06 | 0.31 | -0.15 | 0.13 | 9.65 | 1
0.05 | -0.05 | 0.11 | 0.06 | 0.44 | -0.4 | -0.04 | 9.67 | 7
0.05 | -0.19 | 0.36 | 0.09 | 0.44 | -0.4 | -0.04 | 9.68 | 17
0.06 | -0.17 | 0.34 | 0.08 | -0.08 | 0.46 | 0.01 | 9.7 | 30
0.07 | -0.12 | 0.27 | 0.05 | -0.14 | 0.46 | 0.05 | 9.72 | 43
0.07 | -0.12 | 0.27 | 0.05 | -0.09 | 0.25 | 0.03 | 9.73 | 56
0.08 | -0.01 | 0.02 | 0.01 | -0.09 | 0.25 | 0.03 | 9.75 | 70
0.09 | 0.01 | -0.03 | 0 | 0.01 | -0.02 | -0.02 | 9.77 | 84
0.1 | 0.01 | -0.03 | 0 | 0.02 | -0.03 | -0.02 | 9.79 | 97
0.1 | 0.01 | -0.03 | 0 | 0.02 | -0.03 | -0.02 | 9.8 | 111
0.11 | 0.01 | -0.03 | 0 | 0.02 | -0.03 | -0.02 | 9.82 | 125
0.12 | 0.01 | -0.03 | 0 | 0.02 | -0.03 | -0.02 | 9.84 | 140
0.12 | 0.01 | -0.03 | 0 | 0.02 | -0.03 | -0.02 | 9.86 | 154
0.13 | 0.01 | -0.03 | 0 | 0.02 | -0.03 | -0.02 | 9.88 | 169
0.14 | 0.01 | -0.03 | 0 | 0.02 | -0.03 | -0.02 | 9.89 | 183
0.14 | 0.01 | -0.02 | 0 | 0.02 | -0.03 | -0.02 | 9.91 | 198
0.15 | 0.01 | -0.02 | 0 | 0.02 | -0.03 | -0.02 | 9.93 | 212
0.16 | 0.01 | -0.02 | 0 | 0.02 | -0.03 | -0.02 | 9.95 | 227
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
