COMANDLab/SEA_Exoskeleton/Data/Dynamic Test/Excel Data Files/1_18V.xlsx

time | forearm x | forearm y | forearm z | upper x | upper y | upper z | motor time | position
0.04 | -0.05 | 0.11 | 0.08 | 0.32 | -0.15 | 0.12 | 12.44 | 0
0.05 | -0.05 | 0.11 | 0.08 | 0.46 | -0.4 | -0.05 | 12.46 | 0
0.05 | -0.18 | 0.35 | 0.11 | 0.46 | -0.4 | -0.05 | 12.48 | 0
0.06 | -0.16 | 0.33 | 0.07 | -0.08 | 0.45 | 0.01 | 12.49 | 0
0.07 | -0.1 | 0.21 | 0.04 | -0.14 | 0.45 | 0.05 | 12.51 | 0
0.07 | -0.1 | 0.21 | 0.04 | -0.08 | 0.24 | 0.03 | 12.53 | 0
0.08 | 0 | -0.02 | 0 | -0.08 | 0.24 | 0.03 | 12.54 | 0
0.09 | 0.01 | -0.03 | 0 | 0.01 | -0.02 | -0.02 | 12.56 | 0
0.1 | 0.01 | -0.02 | 0 | 0.02 | -0.03 | -0.02 | 12.58 | 0
0.1 | 0.01 | -0.02 | 0 | 0.02 | -0.03 | -0.02 | 12.59 | 0
0.11 | 0.01 | -0.02 | 0 | 0.02 | -0.03 | -0.02 | 12.61 | 0
0.12 | 0.01 | -0.03 | 0 | 0.02 | -0.03 | -0.02 | 12.63 | 0
0.12 | 0.01 | -0.03 | 0 | 0.02 | -0.03 | -0.02 | 12.65 | 0
0.13 | 0.01 | -0.03 | 0 | 0.02 | -0.03 | -0.02 | 12.66 | 0
0.14 | 0.01 | -0.03 | 0 | 0.02 | -0.03 | -0.02 | 12.68 | 0
0.14 | 0.01 | -0.03 | 0 | 0.02 | -0.03 | -0.02 | 12.69 | 0
0.15 | 0.01 | -0.03 | 0 | 0.01 | -0.03 | -0.02 | 12.71 | 0
0.16 | 0.01 | -0.03 | 0 | 0.01 | -0.03 | -0.02 | 12.73 | 0
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
