COMANDLab/SEA_Exoskeleton/Data/Dynamic Test/Excel Data Files/1_20V.xlsx

time | forearm x | forearm y | forearm z | upper x | upper y | upper z | motor time | position
0.04 | -0.05 | 0.12 | 0.06 | 0.32 | -0.11 | 0.1 | 12.9 | 0
0.05 | -0.05 | 0.12 | 0.06 | 0.48 | -0.4 | -0.06 | 12.92 | 0
0.05 | -0.19 | 0.36 | 0.09 | 0.48 | -0.4 | -0.06 | 12.93 | 0
0.06 | -0.17 | 0.34 | 0.07 | -0.08 | 0.45 | 0.01 | 12.95 | 0
0.07 | -0.11 | 0.24 | 0.05 | -0.14 | 0.45 | 0.05 | 12.97 | 0
0.07 | -0.11 | 0.24 | 0.05 | -0.08 | 0.23 | 0.03 | 12.98 | 0
0.08 | 0 | 0 | 0.01 | -0.08 | 0.23 | 0.03 | 13 | 0
0.09 | 0.01 | -0.03 | 0 | 0.01 | -0.02 | -0.02 | 13.02 | 0
0.1 | 0.01 | -0.03 | 0 | 0.02 | -0.03 | -0.02 | 13.03 | 0
0.1 | 0.01 | -0.03 | 0 | 0.02 | -0.03 | -0.02 | 13.05 | 0
0.11 | 0.01 | -0.03 | 0 | 0.02 | -0.03 | -0.02 | 13.07 | 0
0.12 | 0.01 | -0.03 | 0 | 0.02 | -0.03 | -0.02 | 13.09 | 0
0.12 | 0.01 | -0.03 | 0 | 0.02 | -0.03 | -0.02 | 13.1 | 0
0.13 | 0.01 | -0.03 | 0 | 0.02 | -0.03 | -0.02 | 13.12 | 0
0.14 | 0.01 | -0.03 | 0 | 0.02 | -0.03 | -0.02 | 13.14 | 0
0.14 | 0.01 | -0.03 | 0 | 0.02 | -0.03 | -0.02 | 13.15 | 0
0.15 | 0.01 | -0.03 | 0 | 0.02 | -0.03 | -0.02 | 13.17 | 0
0.16 | 0.01 | -0.03 | 0 | 0.02 | -0.03 | -0.02 | 13.19 | 0
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
