COMANDLab/SEA_Exoskeleton/Data/Static Test/MATLAB Graphs/Integrated Static Test Example - Gear Compliance.png

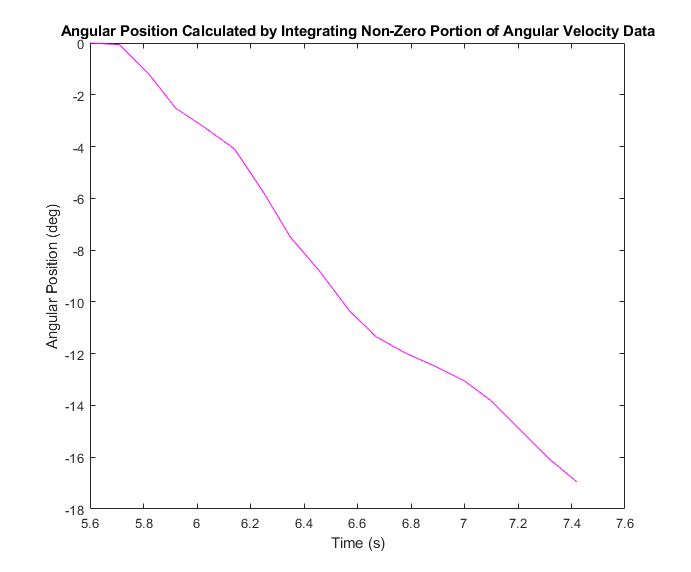
Data/Static Test/MATLAB Graphs/Integrated Static Test Example - Gear Compliance.png
