COMANDLab/SEA_Exoskeleton/Data/Static Test/MATLAB Graphs/Raw Static Test Example - Gear Compliance.png

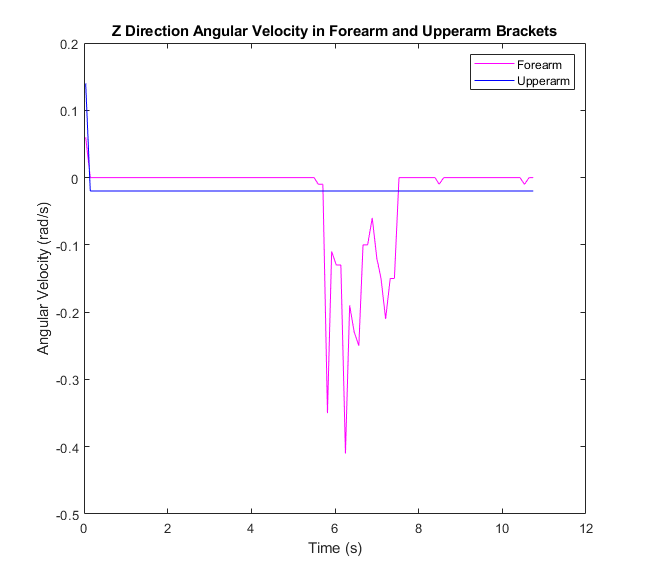
Data/Static Test/MATLAB Graphs/Raw Static Test Example - Gear Compliance.png
