COMANDLab/SEA_Exoskeleton/Data/Torque Test/MATLAB Graphs/10V Labeled.png

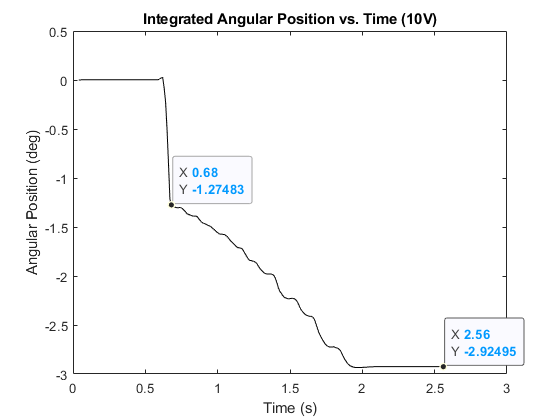
Data/Torque Test/MATLAB Graphs/10V Labeled.png
