COMANDLab/SEA_Exoskeleton/Data/Torque Test/MATLAB Graphs/10V Test_Integrated_Torque_Test.png

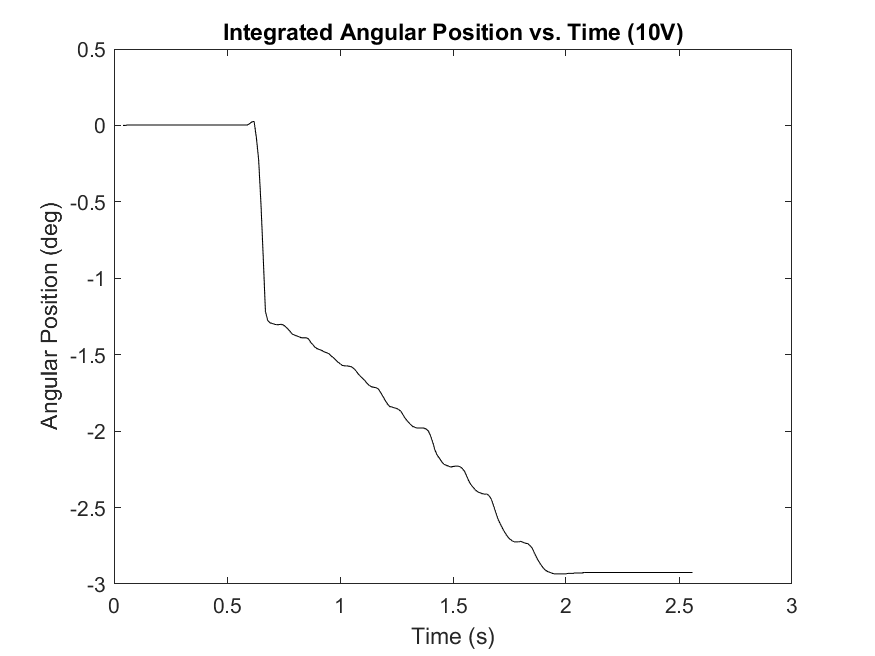
Data/Torque Test/MATLAB Graphs/10V Test_Integrated_Torque_Test.png
