COMANDLab/SEA_Exoskeleton/Data/Torque Test/MATLAB Graphs/12V Labeled.png

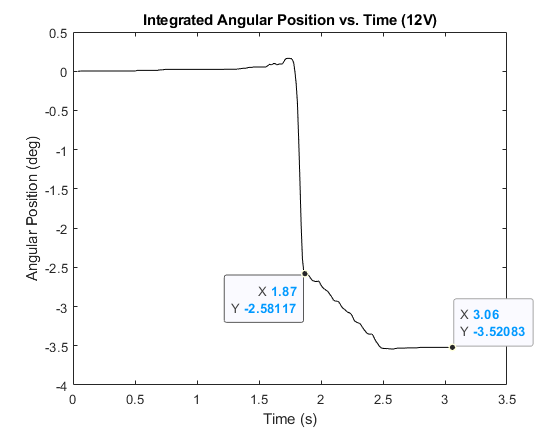
Data/Torque Test/MATLAB Graphs/12V Labeled.png
