COMANDLab/SEA_Exoskeleton/Data/Torque Test/MATLAB Graphs/14V Labeled.png

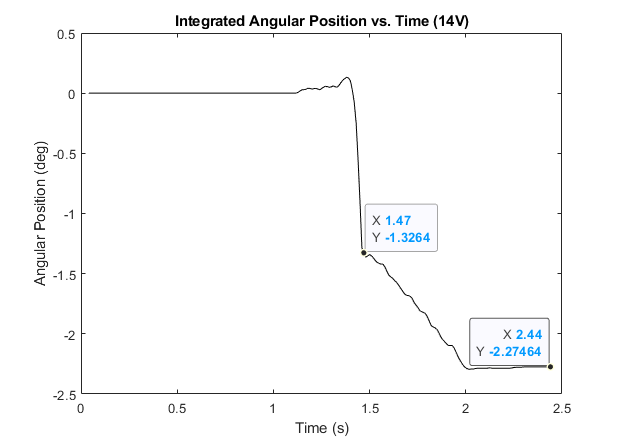
Data/Torque Test/MATLAB Graphs/14V Labeled.png
