COMANDLab/SEA_Exoskeleton/Data/Torque Test/MATLAB Graphs/14V Test_Raw_Torque_Test.png

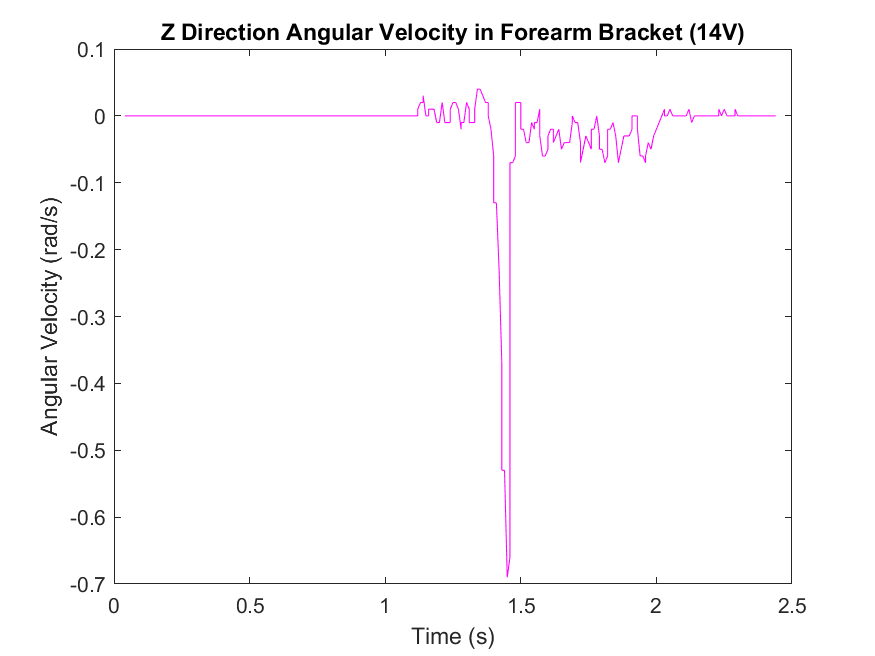
Data/Torque Test/MATLAB Graphs/14V Test_Raw_Torque_Test.png
