COMANDLab/SEA_Exoskeleton/Data/Torque Test/MATLAB Graphs/16V Labeled.png

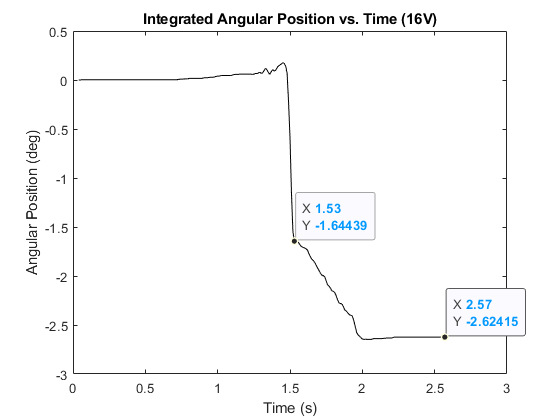
Data/Torque Test/MATLAB Graphs/16V Labeled.png
