COMANDLab/SEA_Exoskeleton/Data/Torque Test/MATLAB Graphs/16V Test_Raw_Torque_Test.png

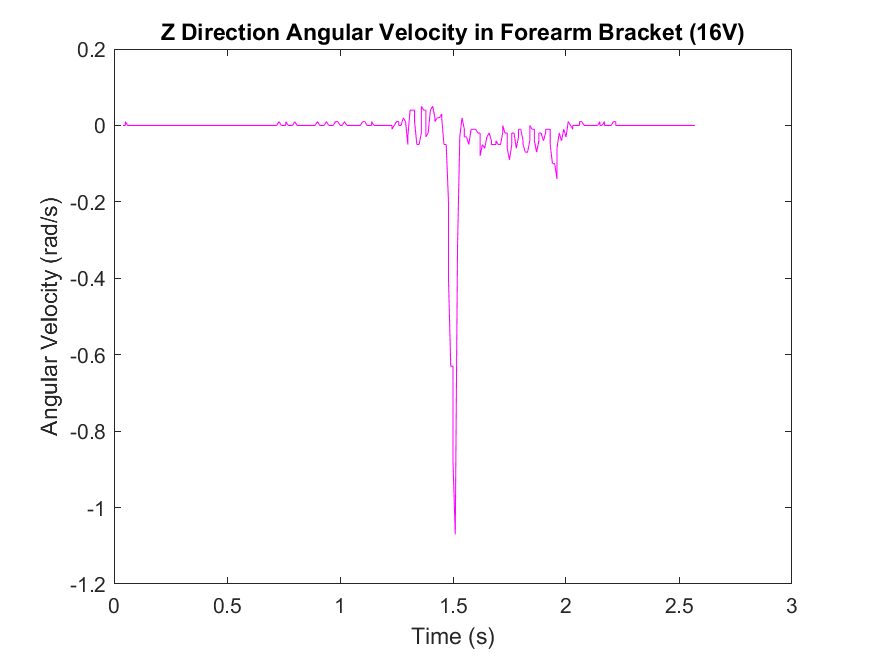
Data/Torque Test/MATLAB Graphs/16V Test_Raw_Torque_Test.png
