COMANDLab/SEA_Exoskeleton/Data/Torque Test/MATLAB Graphs/18V Labeled.png

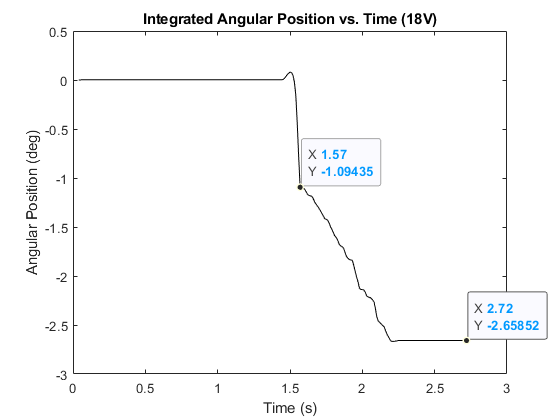
Data/Torque Test/MATLAB Graphs/18V Labeled.png
