COMANDLab/SEA_Exoskeleton/Data/Torque Test/MATLAB Graphs/18V Test_Raw_Torque_Test.png

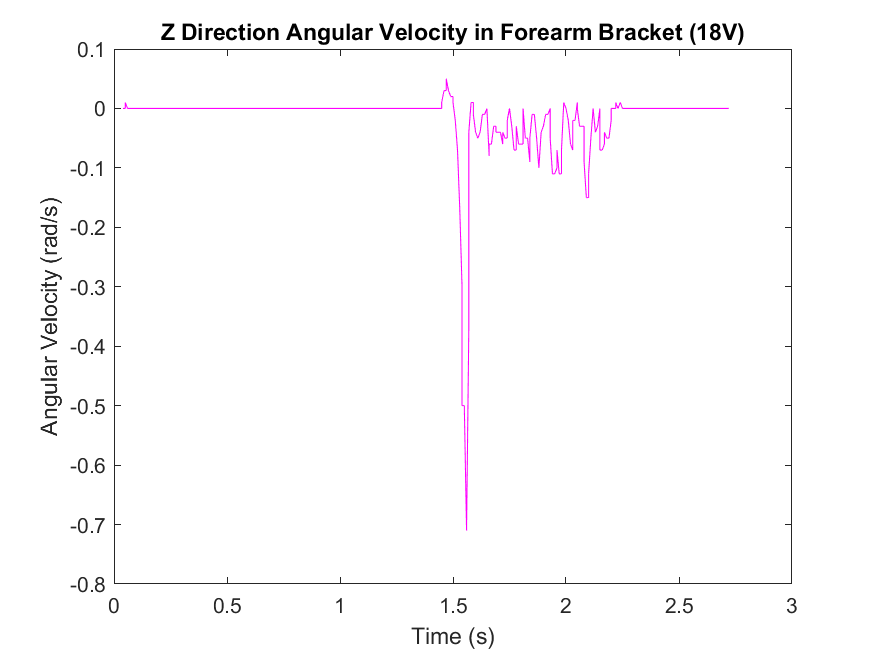
Data/Torque Test/MATLAB Graphs/18V Test_Raw_Torque_Test.png
