COMANDLab/SEA_Exoskeleton/(list of files, drawings)

Other design files:
Data/Circuit Schematics and Fizz Parts/IMU_Setup.fzz
Data/Circuit Schematics and Fizz Parts/Motor Pinout with Breadboard.fzz
Wiring/Motor pinout.fzz
