COMANDLab/SEA_Exoskeleton/(commit log)

2024-04-17 Added all files pertaining to design
    [Arm Bevel v6.step, Arm Bevel.stl, Arm.stl, Bevel Coupler StepDown.stl, Bicep v13.step, Bicep.stl, Compliant Arm v3.step, Compliant Coupler Stepdown.stl]
2024-04-18 Added 3MF file for Compliant Arm
    This includes the printer stop points and setting changes to go from PETG to TPU.
    [Ben_Compliant_Arm_2.3mf]
2024-04-18 Added spring spec sheet
    This schematic include the redline to for the custom spring design to achieve the 90 degree angles.
2024-06-05 Delete STEP Files/Motor Bracket v39.step
    Old file that was updated to Motor Bracket v40
    [Motor Bracket v39.step]
2024-06-05 Delete STL/Motor Bracket.stl
    Deleted to reflect change from v39 to v40 of Motor Bracket step file
    [Motor Bracket.stl]
2024-06-05 Updated to reflect change of v39 to v40 of step file
    [Motor Bracket.stl]
2024-11-14 Added Data
    Added data from tests
    [1_12V.xlsx, 1_14V.xlsx, 1_16V.xlsx, 1_18V.xlsx, 1_20V.xlsx, 2_12V.xlsx, 2_14V.xlsx, 2_16V.xlsx]
2025-01-19 FEA of gears
    FEA for 3 cases on the 3d printed parts looking at stress and displacements.
